monoradio102/stardust-lamp/research/2026-11-cosmic-rays/paper/stardust_en.pdf

## Measuring cosmic-ray muons with a desktop Geiger–M¨uller coincidence lamp

MONORADIO
https: // github. com/ monoradio102/ stardust-lamp (https://github.com/monoradio102/stardust-lamp)

(Dated: November 2026)

Hoshikuzu-to (“stardust lamp”) is a lamp that lights only when two stacked Geiger–M¨uller tubes fire together. We evaluate it as a counter of cosmic-ray muons. A 10-hour run on a desk indoors gave 1,162 coincidences, a rate of R = 1.94 ± 0.06 min⁻¹
. The counts per minute follow a Poisson distribution (χ

2
test, p = 0.1)
and the waiting times an exponential one (KS test, p = 0.4), as expected for independent arrivals. Chance coincidences agree with Racc = 2τRARB and make up 0.04% of the total. A Monte Carlo calculation of the geometric factor from the tube dimensions and the cos²
θ zenith-angle distribution gives a vertical intensity of I0 = 51.3–72.5 m⁻²
s

−1

sr⁻¹
, consistent with the accepted value of about 70. A separate 45.7-hour run with earlier firmware, corrected for double counting of single discharges, gives the same rate within the errors.
I. INTRODUCTION

Primary cosmic rays are mostly protons and nuclei accelerated in supernova remnants in our Galaxy. They collide with nuclei of the air some 15 km up, and the pions they make decay into muons. Most charged particles reaching the ground are these muons; about one crosses each square centimeter of a horizontal surface per minute.¹
The classic way to count them is the coincidence method: stack two or more detectors and keep only the events in which all of them fire. A single Geiger–M¨uller (GM) tube also responds to ambient gamma rays, but at ground level a particle that passes through two tubes at once is almost always a muon.
Hoshikuzu-to performs this coincidence with an analog circuit and shows the result as a soft glow of an LED (Fig. 1). Our aim is to show that the lamp also works as a quantitative instrument. We report (i) tests of the arrival statistics, (ii) a test of the chance-coincidence formula, (iii) a prediction of the rate from the tube geometry and an estimate of the vertical intensity, and (iv) a check of reproducibility with two runs.

II. APPARATUS AND METHOD

A. Detector

The detector is a pair of J321 GM tubes lying horizontally, one above the other (Table I, Fig. 2). A boost converter followed by a voltage doubler supplies the high voltage, which the microcontroller regulates at 360 V.

B. Coincidence and counting

The coincidence is made twice. For the light, charge flows through a two-stage PNP stack into a capacitor only while the pulses of both tubes overlap, so the window is set by the pulse overlap (about 0.1 ms). For the counts, a microcontroller (ATtiny1614) catches the


FIG. 1. Hoshikuzu-to: two stacked GM tubes (back) and the board that glows at the moment of a coincidence (front).

TABLE I. Detector and run conditions.

GM tubes | J321 × 2 (diameter 10 mm, glass 70 mm)
Layout | stacked, axes horizontal, ≈12 mm apart
High voltage | 360 V (run B: 359.2–360.1 V)
Window | τ = 100 µs
Dead time | τd = 200 µs per tube (firmware 1.5.0 on)
Site | indoors, on a desk

falling edge of each tube’s pulse in an interrupt and timestamps it to a microsecond; a pair with |∆t| ≤ τ is a coincidence. It also counts delayed coincidences D with the window shifted by 1 ms. A pulse that comes within τd = 200 µs of the last counted pulse of the same tube is taken as a repeat of the same discharge and ignored (dead time, firmware 1.5.0 on). Counts lost to a nonparalyzable dead time are corrected by n = m/(1−mτd), where n and m are the true and observed rates;⁴
for a
single tube at 20 min⁻¹

, mτd ≈ 7 × 10⁻⁵
, which is negligible. All numbers in this paper come from the digital counts.

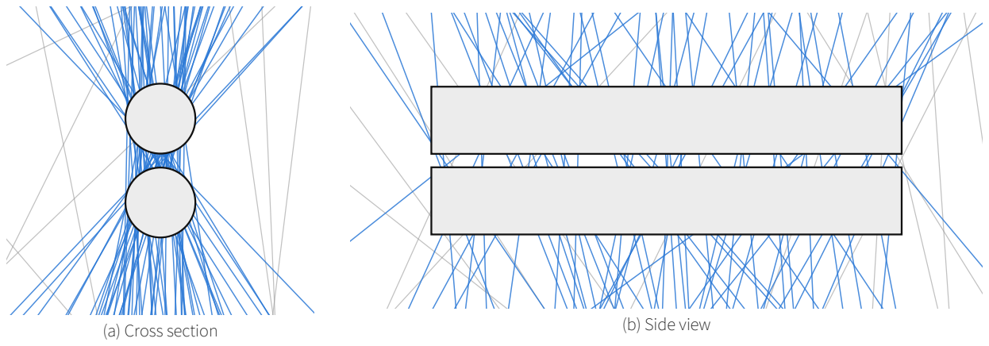
[picture p8: figure]
(a) Cross section; (b) Side view

FIG. 2. Detector geometry. Of the lines generated in the Monte Carlo, those through both tubes (blue, counted) and others (gray).

TABLE II. Runs.

| Firmware | Start (JST) | Length
Run A | 1.4.0 | 2026-11-07 11:01 | 45.7 h
Run B | 1.6.0 | 2026-11-09 09:30 | 10.0 h

TABLE III. Counts and rates (run B).

| Counts | Rate (min⁻¹
)
Coincidences C | 1,162 | 1.937 ± 0.057
Tube A | 10,302 | 17.17
Tube B | 8,130 | 13.55
Delayed D | 1 | —
C. Data taking

The board was connected over USB to a small PC, which recorded (1) 10-s summaries (high voltage, counts of tubes A and B, coincidences C, delayed coincidences D), (2) every hit with the PC’s time stamp (ms), and
(3) for pairs within 5 ms, ∆t = tB − tA measured on the board (µs). Table II lists the two runs. The main results come from run B; run A is used in Sec. III F to check reproducibility. Neither run has a gap longer than 25 s in its 10-s records.

III. RESULTS

A. Rates

Table III gives the counts of run B. The single-tube counts are mostly ambient gamma rays.

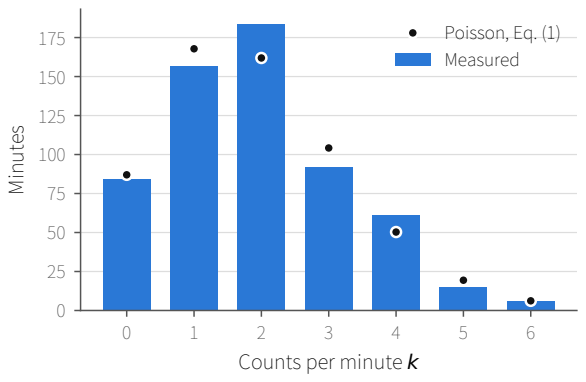
[picture p9: figure]
Counts per minute k; Minutes; Poisson, Eq. (1) Measured

FIG. 3. Coincidences per minute (599 minutes). Dots: Eq. (1) with λ = 1.93.

B. Arrival statistics

If arrivals are independent and the rate R is constant, the number k counted in a time ∆T follows the Poisson distribution and the waiting time ∆t the exponential one,

P(k) = λ

k
e

−λ
k!
, | λ = R ∆T, | (1)

p(∆t) = R e⁻R∆t

, | ∆t1/2 = ln 2 R
. | (2)

The counts per minute have mean 1.93 and variance 1.765, as σ

2 = λ requires (Fig. 3); a χ

2
test of the
whole distribution gives χ

2 = 9.2 for 5 degrees of freedom (p = 0.1). The median waiting time, 22.3 s, matches ∆t1/2 = 21.5 s from Eq. (2) (Fig. 4), and a KS test against the exponential gives p = 0.4. Neither test rejects independent arrivals.

0 | 50 | 100 | 150 | 200 | 250

### Waiting time Δt [s]

1

10

100

### Events / 10 s

Exponential, Eq. (2)
Measured

FIG. 4. Waiting times between coincidences (1,161 intervals). Line: Eq. (2).

0 | 1000 | 2000 | 3000 | 4000 | 5000
|Δt| [μs]

0.1

1

10

100

1,000

### Pairs / 100 μs

Eq. (3)
Coincidence window
Outside the window

FIG. 5. Distribution of |∆t| between the two tubes in 100-µs bins. Dashed line: chance level from Eq. (3).

C. Chance coincidences

Two unrelated hits fall in the window by chance at the rate

Racc = 2 τ RA RB. | (3)

For run B this predicts 0.47 chance events inside the window, 0.04% of the coincidences. Pairs outside the window (0.1 < |∆t| ≤ 5 ms) are all chance overlaps, so their distribution should be flat at the height set by Eq. (3) (Fig. 5). We find 17 such pairs against 22.8 expected, and a delayed-coincidence count of 1 against 0.94 expected.

D. Time differences

A muon crosses the two tubes, about 12 mm apart, in 0.04 ns. The measured time differences instead peak at a median of +16 µs, with 89% between +9 and +17 µs (Fig. 6). This offset comes not from the flight time but from the time the microcontroller takes to service the two

−100 −75 | −50 −25 | 0 | 25 | 50 | 75 | 100
Δt = tB − tA | [μs]

1

10

100

1,000

### Events / 2 μs

FIG. 6. Time differences ∆t | = tB − tA | inside the window.
interrupts in turn. | Both tubes share | one port interrupt,
and the handler services tube A first, so ∆t is shifted by
the run time of A’s | handler | (mean | +15.8 µs). When tube
B falls slightly earlier, the | order is | reversed, which gives
a small peak near −21.4 µs | (9.5% | of | all pairs).
E. Stability
The hourly coincidence | counts of | run B average 116.6
with χ
2 = 6.3 for | 8 degrees of | freedom (p = 0.62);
run A, after correction, gives χ

2 = 49.9 for 43 (p =
0.22). Neither shows changes beyond statistical fluctuation (Fig. 7).
F. | Comparison of the two | runs
Run A was taken | with earlier firmware (1.4.0), before
the dead time was | added. | Its event list contained, 6.8
times per hour, bursts of two to four | coincidences within
10 ms—a pattern that independent | arrivals would pro-
duce about twice in 45 hours. In | each burst one tube
fired again 20–96 µs after | its first | pulse, inside the win-
dow, so the same muon was counted again. Widening
the time differences | to 5 ms | showed | no excess of repeat
pulses beyond 100 µs.
Before correction | the rate | of run | A was 2.14 min⁻¹
,
and its hourly counts scattered more than a Poisson distribution allows (χ
2 = 62.5 | for 43 | degrees of freedom,
p = 0.027). | Treating hits | within | 10 ms on the PC
clock as one discharge brings the | scatter back to Pois-
son (χ
2 = 49.9, p = 0.22) | and gives | 1.98 ± 0.03 min⁻¹
,
which agrees with the 1.94 ± 0.06 min⁻¹
of run B within
0.7 σ (Table IV). In | run B | the burst | rate is 0.0 per hour,
and repeat hits of a tube within 10 ms occur 5.1 times per
hour against 4.8 expected | by chance. An error that the
mean alone would hide can | thus be | found and corrected
with the same statistical tests as in | Sec. III B, provided
every event is time-stamped.

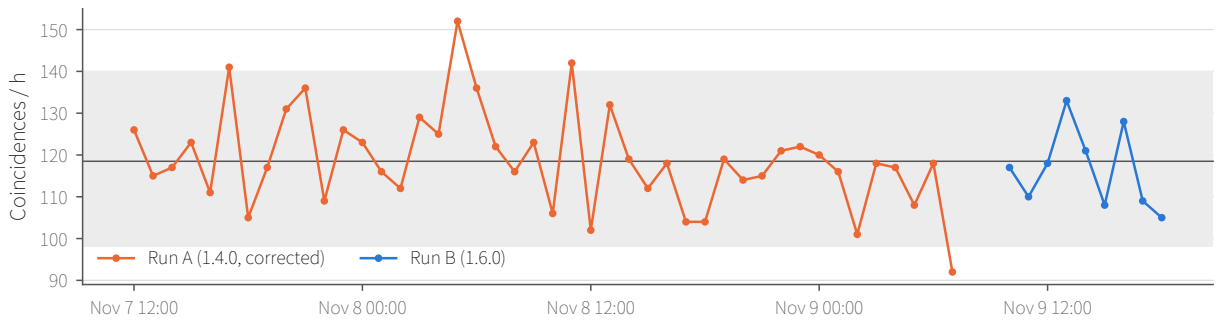
[picture p10: figure]
Nov 7 12:00; Nov 8 00:00; Nov 8 12:00; Nov 9 00:00; Nov 9 12:00; Coincidences / h; Run A (1.4.0, corrected); Run B (1.6.0)

FIG. 7. Hourly coincidences. The band holds 95% of a Poisson distribution with the mean shown by the line. Run A is corrected as described in Sec. III F.

TABLE IV. Comparison of the two runs. χ

2
is for the hourly
counts; a burst is coincidences following each other within 10 ms.
| | Run A | Run B
| raw | corrected
Rate (min⁻¹
) | 2.14 | 1.98 ± 0.03 | 1.94 ± 0.06
χ

2
/dof | 62.5/43 | 49.9/43 | 6.3/8
Its p value | 0.027 | 0.22 | 0.62
Bursts (h⁻¹
) | 6.8 | — | 0.0
IV. | GEOMETRIC ACCEPTANCE AND VERTICAL
INTENSITY

The intensity of muons at ground level depends on the zenith angle θ roughly as¹

I(θ) = I0 cos²
θ. | (4)

Let A⊥(θ, ϕ) be the area, projected on a plane perpendicular to the direction (θ, ϕ), of the bundle of lines that pass through both tubes. The rate is then

R = ε I0 G, G ≡

∫︂

Ω

cos²
θ A⊥(θ, ϕ) dΩ, (5)

where ε lumps together the detection efficiency and shielding. We computed the geometric factor G by a Monte Carlo that draws lines through a horizontal plane weighted by cos³
θ. Since the sensitive length of the tubes cannot be measured directly, we used both the glass length, 7 cm, and 5 cm, which leaves out the electrodes at the ends (Table V).
Solving Eq. (5) with ε = 1 gives I0 = R/G = 51.3– 72.5 m⁻²
s

−1

sr⁻¹
. The range includes the accepted value of about 70 m⁻²
s

−1

sr⁻¹

1 Shielding indoors and an efficiency below unity (ε < 1) make this consistent. The counted muons arrive at a median zenith angle of 27◦ (Fig. 8): the intensity peaks at the vertical, but the solid angle near the zenith is small, so the distribution peaks

TABLE V. Geometric factor and predicted rate (I0 = 70 m⁻²
s

−1

sr⁻¹
, ε = 1).
Length | G (cm²
sr) | Predicted | Measured | Ratio
5 cm | 4.45 | 1.87 | 1.94 | 1.04
7 cm | 6.29 | 2.64 | 1.94 | 0.73

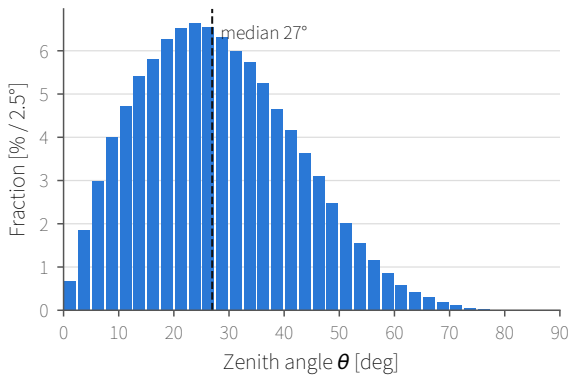
[picture p11: figure]
Zenith angle θ [deg]; Fraction [% / 2.5°]; median 27°

FIG. 8. Zenith angles of counted muons (Monte Carlo, 7-cm sensitive length).

at 20–30◦
. Systematic uncertainties in the predicted rate and in I0 come from the uncertain sensitive length (the spread in Table V), efficiency and shielding (ε), and the measured tube spacing (1 mm changes G by about 8%).
V. DISCUSSION: TIME DILATION

The muon lifetime is τµ = 2.197 µs,¹
so even at the
speed of light a muon would travel only cτµ ≈ 659 m. That muons made 15 km up are counted at the ground is due to the time dilation of special relativity,²,3

γ =

E
mµc

2

, L = γβcτµ,

N(h)
N0

= e

−h/L
. (6)

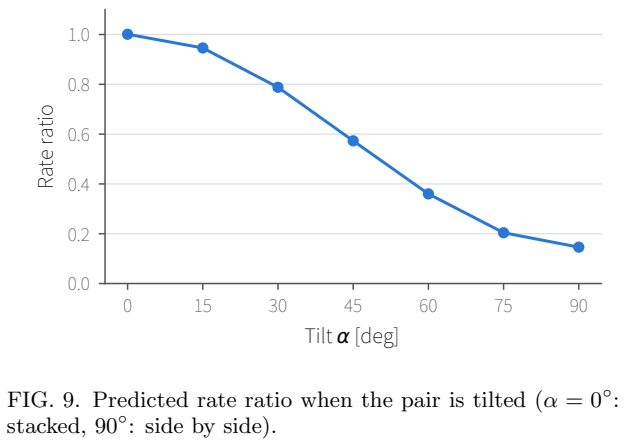
[picture p12: figure]
Tilt α [deg]; Rate ratio; stacked, 90◦; : side by side).

FIG. 9. Predicted rate ratio when the pair is tilted (α = 0◦

For a typical ground-level energy E ≈ 4 GeV, γ ≈ 38 and L ≈ 25 km, so a fraction 0.55 survives 15 km; without time dilation it would be 1.3×10⁻¹⁰ (energy loss in the air is ignored). The two coincidences a minute are a modest witness that time dilation is real.

VI. CONCLUSION

A lamp built as a decorative object works as a quantitative counter of cosmic-ray muons. The coincidence rate is 1.94 ± 0.06 min⁻¹
and the arrivals follow a Poisson process. Chance coincidences agree with Eq. (3) and make up 0.04% of the total. The prediction from the tube geometry and the cos²
θ distribution agrees with the measurement and gives I0 = 51.3–72.5 m⁻²
s

−1

sr⁻¹

Statistical tests on the event record found and corrected double counting in the counting chain, and after correction the two runs agree within the errors.

VII. FURTHER WORK

The relative statistical error is σR/R = 1/

√
N; one
lamp counts about 2,789 events a day, fixing the daily rate to ±1.9%. Tilting the pair by an angle α about the tube axis changes the accepted zenith angles; Fig. 9 shows the rate ratio predicted from Eq. (5), and a day at each angle would test Eq. (4). Other studies within reach are the barometric effect (∆R/R = β∆P with β ≈ −0.1 to −0.2%/hPa⁵
), Forbush decreases after solar eruptions,⁶
extensive air showers with two lamps, and the dependence on location.

DATA AND CODE

The analysis code, results, data, schematics and
firmware | are | available | at | https://github.com/
monoradio102/stardust-lamp. (https://github.com/monoradio102/stardust-lamp)

1S. Navas et al. (Particle Data Group), “Review of Particle Physics,” Phys. Rev. D 110, 030001 (2024).
2B. Rossi and D. B. Hall, “Variation of the rate of decay of mesotrons with momentum,” Phys. Rev. 59, 223 (1941).
3D. H. Frisch and J. H. Smith, “Measurement of the relativistic time dilation using µ-mesons,” Am. J. Phys. 31, 342 (1963). 4G. F. Knoll, Radiation Detection and Measurement, 4th ed. (Wiley, 2010).
5L. I. Dorman, Cosmic Rays in the Earth’s Atmosphere and Underground (Springer, 2004).
6S. E. Forbush, “On the effects in cosmic-ray intensity observed during the recent magnetic storm,” Phys. Rev. 51, 1108 (1937).
