monoradio102/stardust-lamp/research/2026-11-cosmic-rays/paper/stardust_ja.pdf

# 卓上ガイガー＝ミュラー管コインシデンス灯 「星屑灯」による宇宙線ミューオンの計測

## Measuring cosmic-ray muons with a desktop Geiger–Müller coincidence lamp MONORADIO

2026 年 11 月　 · https://github.com/monoradio102/stardust-lamp

要旨　上下に重ねた 2 本のガイガー＝ミュラー（GM）管が同時に反応したときだけ光るランプ「星屑灯」を，宇宙線ミューオンの計 数器として評価した．屋内の机上で 10.0 時間の連続観測を行い，1,162 事象の同時計数を得た．計数率は R = 1.94±0.06 min⁻¹ である．1 分ごとの計数はポアソン分布に（χ

2 検定 p = 0.1），到来間隔は指数分布に（KS 検定 p = 0.4）従い，到来が独立な 事象の列であることを確かめた．偶然同時計数は理論式 Racc = 2τRARB どおりで，全体の 0.04% にとどまる．管の寸法と天
頂角分布 I(θ) = I0 cos²

θ から幾何学的因子をモンテカルロ法で求め，鉛直強度 I0 = 51.3–72.5 m⁻²
s

−1

sr⁻¹ を得た．これは
文献値（約 70）と整合する．ファームウェアの異なる 45.7 時間の観測（同じ放電の二重計数を補正）とも，計数率は誤差の範 囲で一致した．
キーワード　宇宙線，ミューオン，GM 計数管，同時計数法，ポアソン過程，幾何学的因子

### 1 はじめに

一次宇宙線は，主に銀河内の超新星残骸で加速された
陽子や原子核である．これが上空 15 km 前後で大気の原 子核と衝突し，π 中間子を経てミューオンが生まれる．地 上に届く荷電粒子の大部分はこのミューオンであり，水
平な面 1 cm² あたり毎分およそ 1 個が通過する [1]． ミューオンを数える古典的な方法は，2 つ以上の検出器 を重ね，すべてが同時に反応した事象だけを選ぶ同時計
数法である．単独の GM 管は環境のガンマ線にも反応す るが，2 本を同時に貫く粒子は，地上ではほぼミューオン に限られる．
星屑灯は，この同時計数をアナログ回路で行い，その
結果を LED の光として見せる照明である（図 1）．本研 究の目的は，この装置が定量的な測定器として使えるこ
とを示すことにある．具体的には，(i) 到来の統計の検証， (ii) 偶然同時計数の理論式の検証，(iii) 管の幾何からの計 数率の予言と鉛直強度の推定，(iv) 2 回の観測による再現 性の確認，を報告する．

### 2 装置と方法

2.1 検出器
検出器は GM 管 J321 を 2 本，軸を水平にして上下に 重ねたものである（表 1，図 2）．高圧はブースト回路と倍 電圧回路で作り，マイコンが帰還をかけて 360 V に保つ． 2.2 同時計数と計数系
同時計数は 2 段で行う．光は，2 本の管のパルスが 重なっている間だけ，2 段の PNP トランジスタを通し てコンデンサに電荷が入ることで生じる．窓はパルスの
重なりで決まり，約 0.1 ms である．計数は，マイコン


図 1 星屑灯．上下に重ねた 2 本の GM 管（奥）と，同時計数 の瞬間に光る基板（手前）．

表 1 検出器と観測の条件
GM 管 | J321 × 2（外径 10 mm，ガラス長 70 mm）
配置 | 軸を水平に上下に重ねる．中心間隔 約 12 mm
印加電圧 360 V（観測 B の実測 359.2–360.1 V）
同時の窓 τ = 100 µs
不感時間 τd = 200 µs（管ごと，1.5.0 以降）
場所 屋内，机の上

（ATtiny1614）が各管のパルスの立ち下がりを割り込み で捉え，時刻を µs 単位で記録して行う．2 本の時間差が |∆t| ≤ τ のとき同時計数とする．あわせて，窓を 1 ms ず らした遅延同時計数 D を数える．同じ管のパルスが，直 前に数えたパルスから τd = 200 µs 以内に来た場合は，同 じ放電の再パルスとみなして数えない（不感時間，ファー ムウェア 1.5.0 以降）．非まひ型の不感時間による数え落 としは，真の計数率を n，観測した計数率を m として n = m/(1−mτd) で補正できる [4]．単独の管で 20 min⁻¹ でも mτd ≈ 7 × 10⁻⁵ であり，補正は無視できる．本論

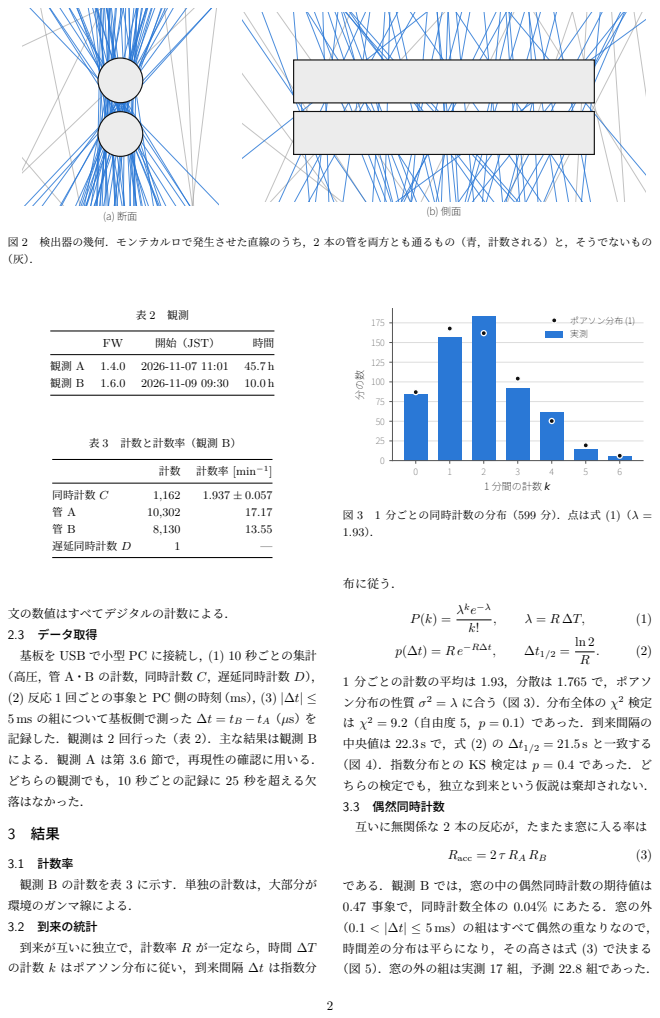
[picture p21: page 2]
開始（JST）; 表 3 計数と計数率（観測 B）; 同時計数 C; 遅延同時計数 D; 1 分間の計数 k; 分の数; ポアソン分布 (1) 実測; 図 3 1 分ごとの同時計数の分布（599 分）．点は式 (1)（λ =; 布に従う．; 2 = λ に合う（図 3）．分布全体の χ; Racc = 2 τ RA RB

図 2 検出器の幾何．モンテカルロで発生させた直線のうち，2 本の管を両方とも通るもの（青，計数される）と，そうでないもの

計数 計数率 [min⁻¹

文の数値はすべてデジタルの計数による．
2.3 データ取得
基板を USB で小型 PC に接続し，(1) 10 秒ごとの集計
（高圧，管 A・B の計数，同時計数 C，遅延同時計数 D），
(2) 反応 1 回ごとの事象と PC 側の時刻（ms），(3) |∆t| ≤
5 ms の組について基板側で測った ∆t = tB − tA（µs）を
記録した．観測は 2 回行った（表 2）．主な結果は観測 B
による．観測 A は第 3.6 節で，再現性の確認に用いる．
どちらの観測でも，10 秒ごとの記録に 25 秒を超える欠
落はなかった．
3.1 計数率
観測 B の計数を表 3 に示す．単独の計数は，大部分が
環境のガンマ線による．
3.2 到来の統計
到来が互いに独立で，計数率 R が一定なら，時間 ∆T
の計数 k はポアソン分布に従い，到来間隔 ∆t は指数分

1 分ごとの計数の平均は 1.93，分散は 1.765 で，ポアソ
ン分布の性質 σ
2 = 9.2（自由度 5，p = 0.1）であった．到来間隔の
中央値は 22.3 s で，式 (2) の ∆t1/2 = 21.5 s と一致する
（図 4）．指数分布との KS 検定は p = 0.4 であった．ど
ちらの検定でも，独立な到来という仮説は棄却されない．
3.3 偶然同時計数
互いに無関係な 2 本の反応が，たまたま窓に入る率は

である．観測 B では，窓の中の偶然同時計数の期待値は
0.47 事象で，同時計数全体の 0.04% にあたる．窓の外
（0.1 < |∆t| ≤ 5 ms）の組はすべて偶然の重なりなので，
時間差の分布は平らになり，その高さは式 (3) で決まる
（図 5）．窓の外の組は実測 17 組，予測 22.8 組であった．

0 | 50 | 100 | 150 | 200 | 250
到来間隔 Δt [s]

1

10

100
事象数 / 10 s

指数分布 (2)
実測

図 4 同時計数の到来間隔の分布（1,161 個）．線は式 (2)．

0 | 1000 | 2000 | 3000 | 4000 | 5000
|Δt| [μs]

0.1

1

10

100

1,000

組

の

数 / 100 μs

式 (3) の予測
同時の窓
窓の外

図 5 2 本の管の時間差 |∆t| の分布（100 µs ごと）．破線は 式 (3) から求めた偶然同時計数の高さ．

遅延同時計数 D も，予測 0.94 事象に対して実測 1 事象 であった．
3.4 時間差分布
ミューオンは約 12 mm 離れた 2 本の管を 0.04 ns で通 り抜ける．一方，測った時間差の中央値は +16 µs で，同 時計数の 89% が +9–+17 µs に集まる（図 6）．この差は 粒子の飛行時間ではなく，マイコンが 2 本の割り込みを 順に処理する時間による．2 本の管の信号は同じポート の割り込みで受け，マイコンは管 A から順に処理する． そのため ∆t は管 A の処理時間だけ正にずれる（平均 +15.8 µs）．管 B がわずかに早く立ち下がると処理の順 が入れ替わり，−21.4 µs 付近に小さな山（全体の 9.5%） ができる．
3.5 時間的な安定性
観測 B の 1 時間ごとの計数は平均 116.6 で，ばらつ きの χ

2 は 6.3（自由度 8，p = 0.62）であった．観測 A （補正後）も χ

2 = 49.9（自由度 43，p = 0.22）で，統計
的な揺れを超える変化は見られない（図 7）．
3.6 2 回の観測の比較
観測 A は，不感時間を入れる前のファームウェア
（1.4.0）で行った．その事象列には，10 ms 以内に同時
−100 −75 | −50 −25 | 0 | 25 | 50 | 75 | 100
Δt = tB − tA | [μs]

1

10

100

1,000

事

象

数 / 2 μs

図 6 窓の中の時間差 ∆t = tB − tA の分布．

表 4 2 回の観測の比較．χ

2 は 1 時間ごとの計数のばらつき，
塊は 10 ms 以内に続く同時計数．
観測 A | 観測 B
| 補正前 | 補正後
計数率 [min⁻¹
] | 2.14 | 1.98 ± 0.03 1.94 ± 0.06

χ

2

/自由度 | 62.5/43 | 49.9/43 | 6.3/8
その p 値 | 0.027 | 0.22 | 0.62
塊 [h⁻¹
] | 6.8 | — | 0.0

計数が 2–4 回続く塊が 1 時間あたり 6.8 回あった．到来 が独立なら，45 時間でおよそ 2 回しか起きない並びであ る．塊の中では，片方の管が最初のパルスから 20–96 µs 遅れて再びパルスを出し，それが窓に入って同じミュー
オンを重ねて数えていた．時間差を 5 ms まで広げても， 100 µs より外に再パルスの過剰はなかった．
補正前の計数率は 2.14 min⁻¹ で，1 時間ごとのばらつ きもポアソン分布より大きかった（χ
| | | 2 = 62.5，自由度
43，p = 0.027）．PC 側の時刻で 10 ms 以内に続いた反 応を 1 回の放電にまとめると，χ
2 | = | 49.9（p = 0.22）で
ポアソンの揺れに収まり，計数率は 1.98 ± 0.03 min⁻¹ と なった．不感時間を入れた観測 B の 1.94 ± 0.06 min⁻¹ とは，差が 0.7 σ で一致する（表 4）．観測 B では塊は 1 時間あたり 0.0 回，同じ管の 10 ms 以内の再反応は 5.1 回で，偶然に重なる期待値 4.8 回と変わらない．平均値だ けでは気づきにくい誤りも，事象ごとの時刻を残してお
けば，第 3.2 節と同じ統計の検定で見つけて補正できる．

### 4 幾何学的受け入れと鉛直強度

地上のミューオンの強度は，天頂角 θ に対して近似的に

I(θ) = | I0 cos²
θ | (4)
と表される [1]．方向 (θ, ϕ) | について，2 本の管を両方と
も通る直線の束をその方向に垂直な面へ射影した面積を

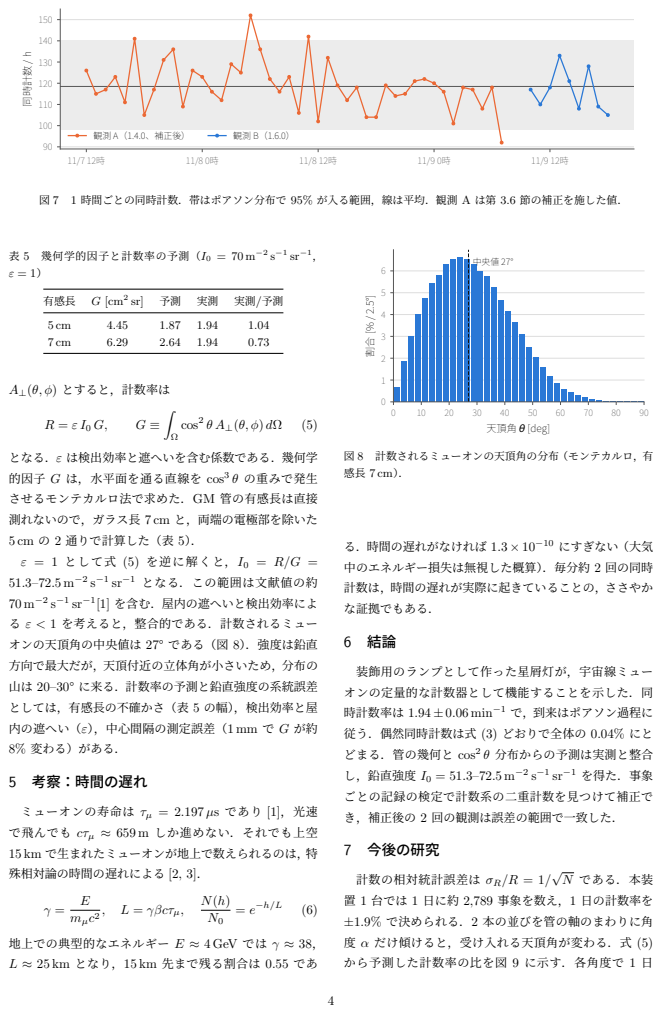
[picture p22: page 4]
同時計数 / h; 観測 A（1.4.0、補正後）; 表 5 幾何学的因子と計数率の予測（I0 = 70 m⁻²; 有感長 G [cm²; A⊥(θ, ϕ) とすると，計数率は; cos²; θ の重みで発生; mµc; L = γβcτµ,; 天頂角 θ [deg]; 中央値 27°; 図 8 計数されるミューオンの天頂角の分布（モンテカルロ，有 感長 7 cm）．; θ 分布からの予測は実測と整合; sr⁻¹ を得た．事象; √ N である．本装

図 7 1 時間ごとの同時計数．帯はポアソン分布で 95% が入る範囲，線は平均．観測 A は第 3.6 節の補正を施した値．

となる．ε は検出効率と遮へいを含む係数である．幾何学
的因子 G は，水平面を通る直線を cos³
させるモンテカルロ法で求めた．GM 管の有感長は直接
測れないので，ガラス長 7 cm と，両端の電極部を除いた
5 cm の 2 通りで計算した（表 5）．
ε = 1 として式 (5) を逆に解くと，I0 = R/G =

る．時間の遅れがなければ 1.3 × 10⁻¹⁰ にすぎない（大気
中のエネルギー損失は無視した概算）．毎分約 2 回の同時
計数は，時間の遅れが実際に起きていることの，ささやか
な証拠でもある．

sr⁻¹ となる．この範囲は文献値の約
[1] を含む．屋内の遮へいと検出効率によ
る ε < 1 を考えると，整合的である．計数されるミュー
オンの天頂角の中央値は 27° である（図 8）．強度は鉛直
方向で最大だが，天頂付近の立体角が小さいため，分布の
山は 20–30° に来る．計数率の予測と鉛直強度の系統誤差
としては，有感長の不確かさ（表 5 の幅），検出効率と屋
内の遮へい（ε），中心間隔の測定誤差（1 mm で G が約
8% 変わる）がある．
5 考察：時間の遅れ

装飾用のランプとして作った星屑灯が，宇宙線ミュー
オンの定量的な計数器として機能することを示した．同
時計数率は 1.94 ± 0.06 min⁻¹ で，到来はポアソン過程に
従う．偶然同時計数は式 (3) どおりで全体の 0.04% にと
どまる．管の幾何と cos²
し，鉛直強度 I0 = 51.3–72.5 m⁻²
ごとの記録の検定で計数系の二重計数を見つけて補正で
き，補正後の 2 回の観測は誤差の範囲で一致した．
7 今後の研究

ミューオンの寿命は τµ = 2.197 µs であり [1]，光速
で飛んでも cτµ ≈ 659 m しか進めない．それでも上空
15 km で生まれたミューオンが地上で数えられるのは，特
殊相対論の時間の遅れによる [2, 3]．

計数の相対統計誤差は σR/R = 1/
置 1 台では 1 日に約 2,789 事象を数え，1 日の計数率を
±1.9% で決められる．2 本の並びを管の軸のまわりに角
度 α だけ傾けると，受け入れる天頂角が変わる．式 (5)
から予測した計数率の比を図 9 に示す．各角度で 1 日

地上での典型的なエネルギー E ≈ 4 GeV では γ ≈ 38，
L ≈ 25 km となり，15 km 先まで残る割合は 0.55 であ

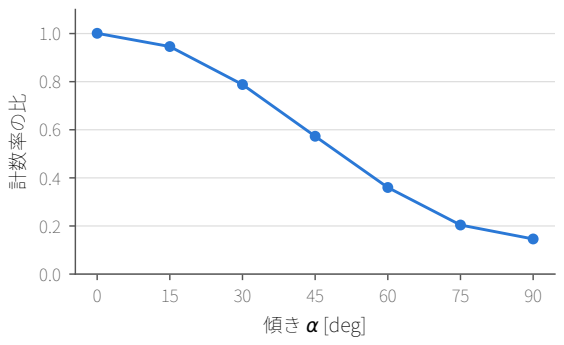
[picture p23: figure]
傾き α [deg]; 計数率の比

図 9 2 本の並びを傾けたときの計数率の比の予測（α = 0 が 上下，90° が横並び）．

ずつ測れば式 (4) を検証できる．このほか，気圧効果

（∆R/R = β∆P，β ≈ −0.1 から −0.2 %/hPa[5]），太陽
活動による減少（フォーブッシュ減少 [6]），2 台による空 気シャワーの検出，場所による違いの測定が可能である．

### データとコード

解 析 コ ー ド， 結 果 の 数 値， デ ー タ， 回 路 図， フ ァームウェアは https://github.com/monoradio102/stardust-lamp (https://github.com/monoradio102/stardust-lamp) で公開している．

### 参考文献

[1] S. Navas et al. (Particle Data Group), Phys. Rev. D 110, 030001 (2024).
[2] B. Rossi and D. B. Hall, Phys. Rev. 59, 223 (1941).
[3] D. H. Frisch and J. H. Smith, Am. J. Phys. 31, 342 (1963).
[4] G. F. Knoll, Radiation Detection and Measurement, 4th ed. (Wiley, 2010).
[5] L. I. Dorman, Cosmic Rays in the Earth’s Atmosphere and Underground (Springer, 2004).
[6] S. E. Forbush, Phys. Rev. 51, 1108 (1937).
