monoradio102/stardust-lamp/research/2026-11-cosmic-rays/paper/figures/en/coincidence.pdf

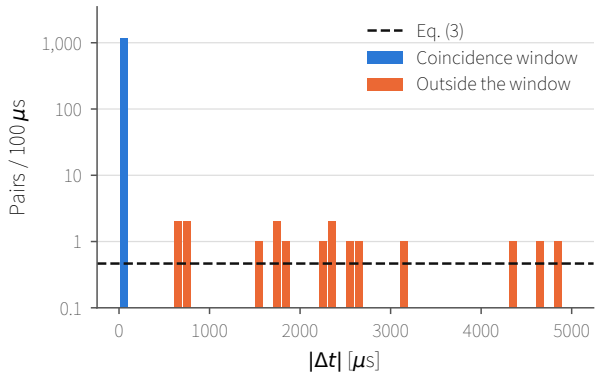
[picture p24: figure]
Pairs / 100 μs; Eq. (3) Coincidence window Outside the window
