monoradio102/stardust-lamp/research/2026-11-cosmic-rays/paper/figures/en/zenith.pdf

0 | 10 | 20 | 30 | 40 | 50 | 60 | 70 | 80 | 90 Zenith angle θ [deg]

0123456
Fraction [% / 2.5°]

median 27°
