monoradio102/stardust-lamp/research/2026-11-cosmic-rays/paper/figures/ja/coincidence.pdf

0 | 1000 | 2000 | 3000 | 4000 | 5000 |Δt| [μs]

0.11

10

100

1,000

組の数 / 100 μs

式 (3) の予測
同時の窓
窓の外
