monoradio102/stardust-lamp/brand/hoshikuzu_horizontal_ink.png

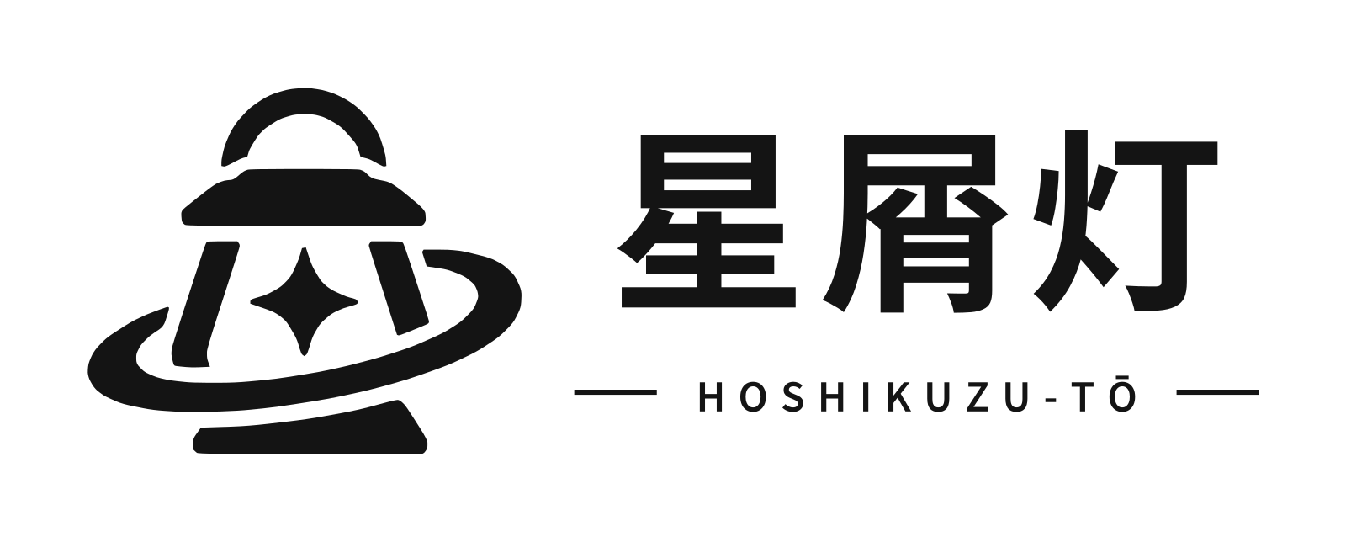
brand/hoshikuzu_horizontal_ink.png
