monoradio102/stardust-lamp/brand/hoshikuzu_stacked_ink.png

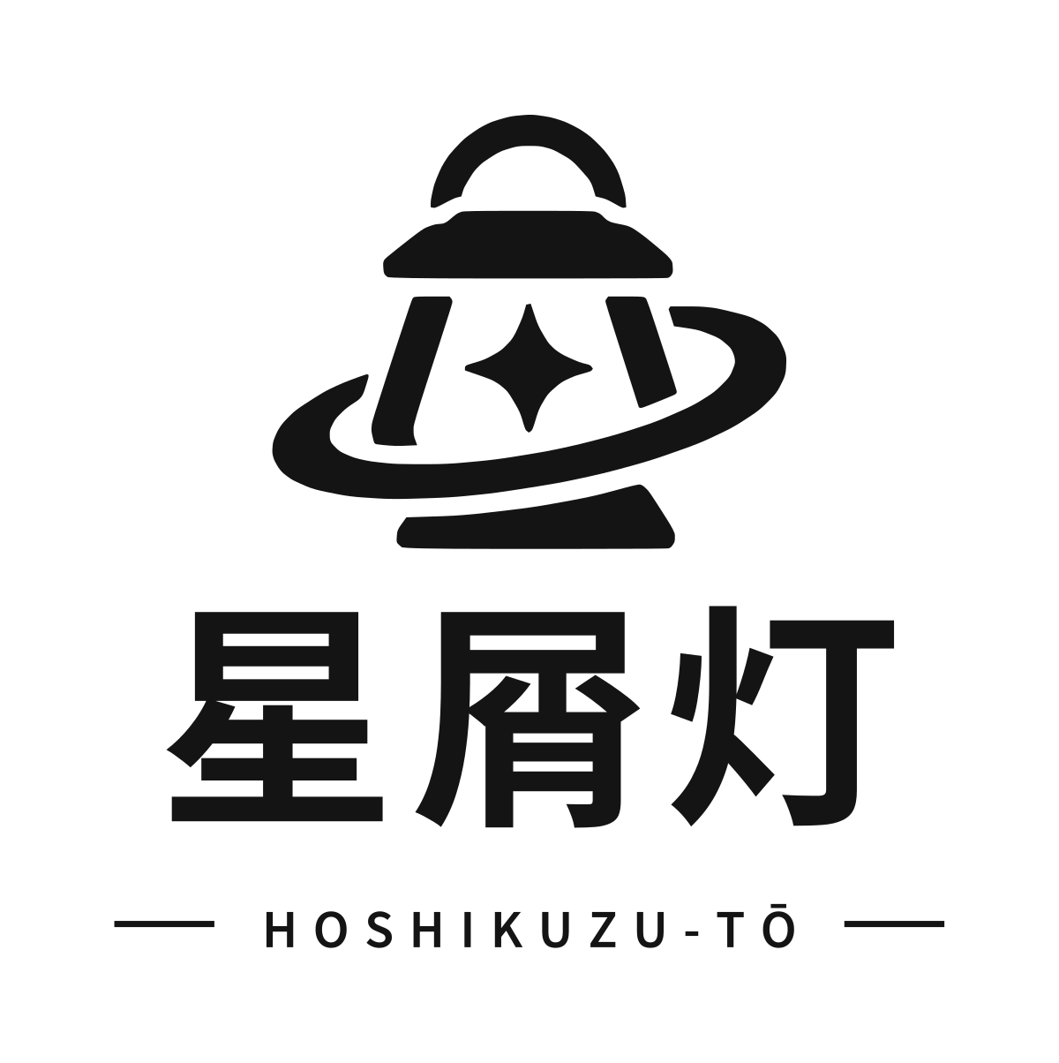
brand/hoshikuzu_stacked_ink.png
