monoradio102/stardust-lamp/hardware/images/schematic_1.png

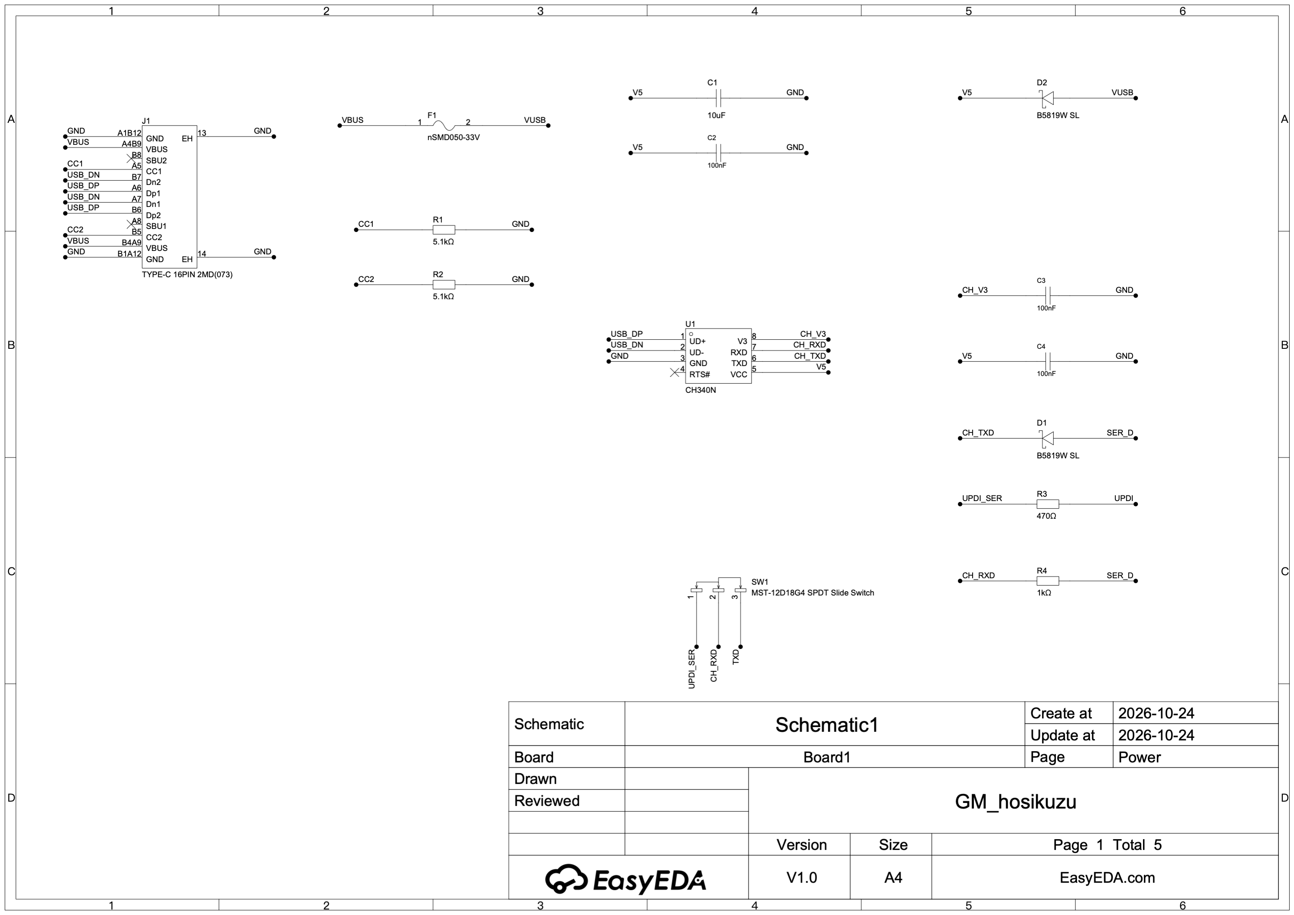
hardware/images/schematic_1.png
