monoradio102/stardust-lamp/hardware/images/schematic_2.png

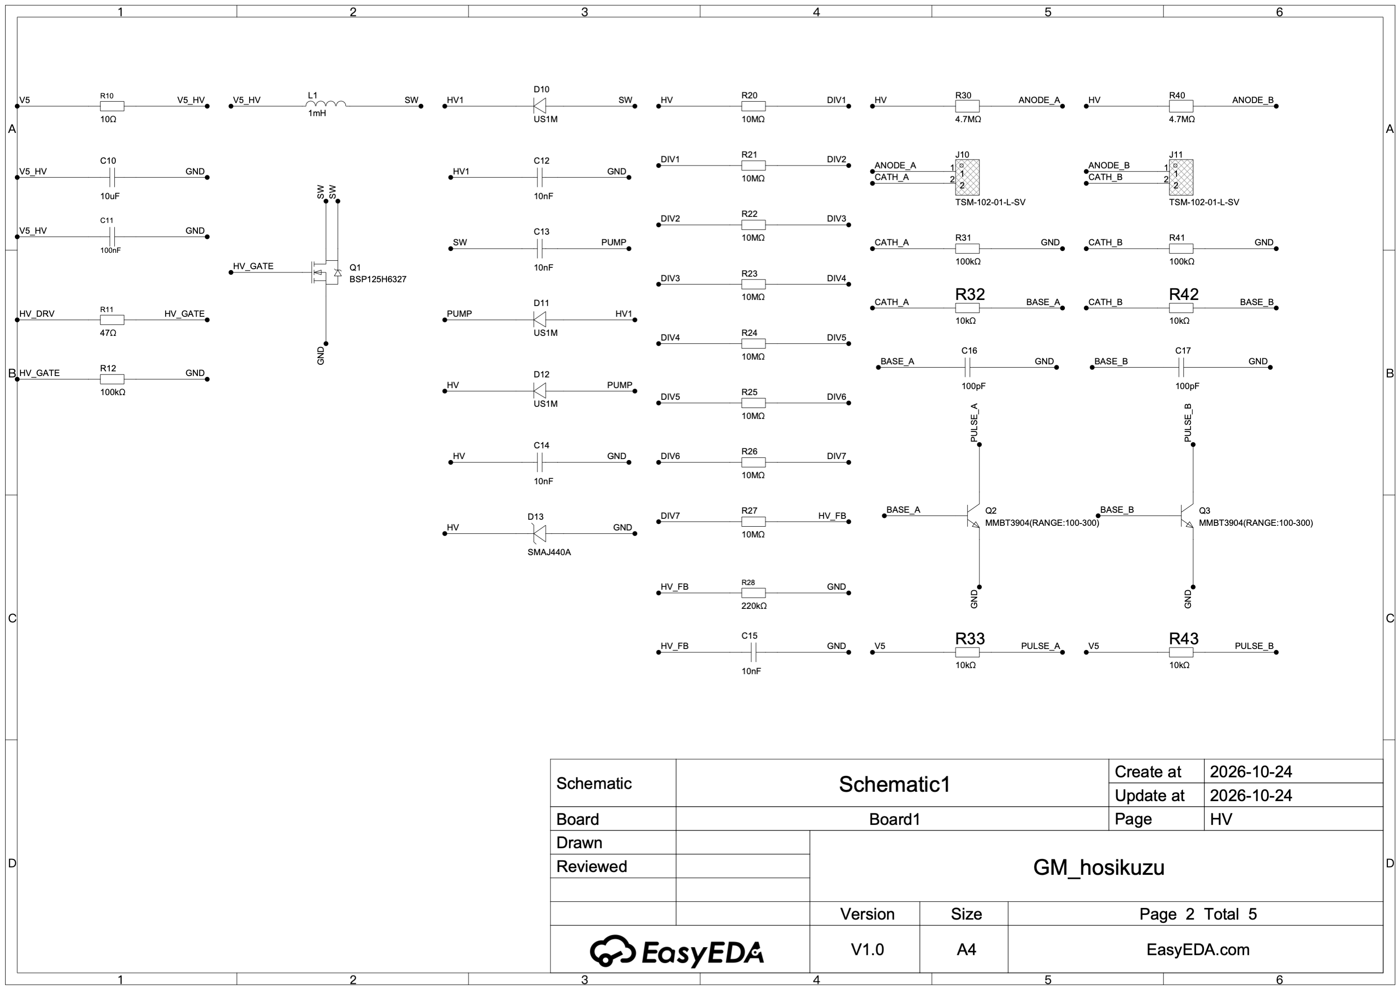
hardware/images/schematic_2.png
