monoradio102/stardust-lamp/hardware/images/schematic_3.png

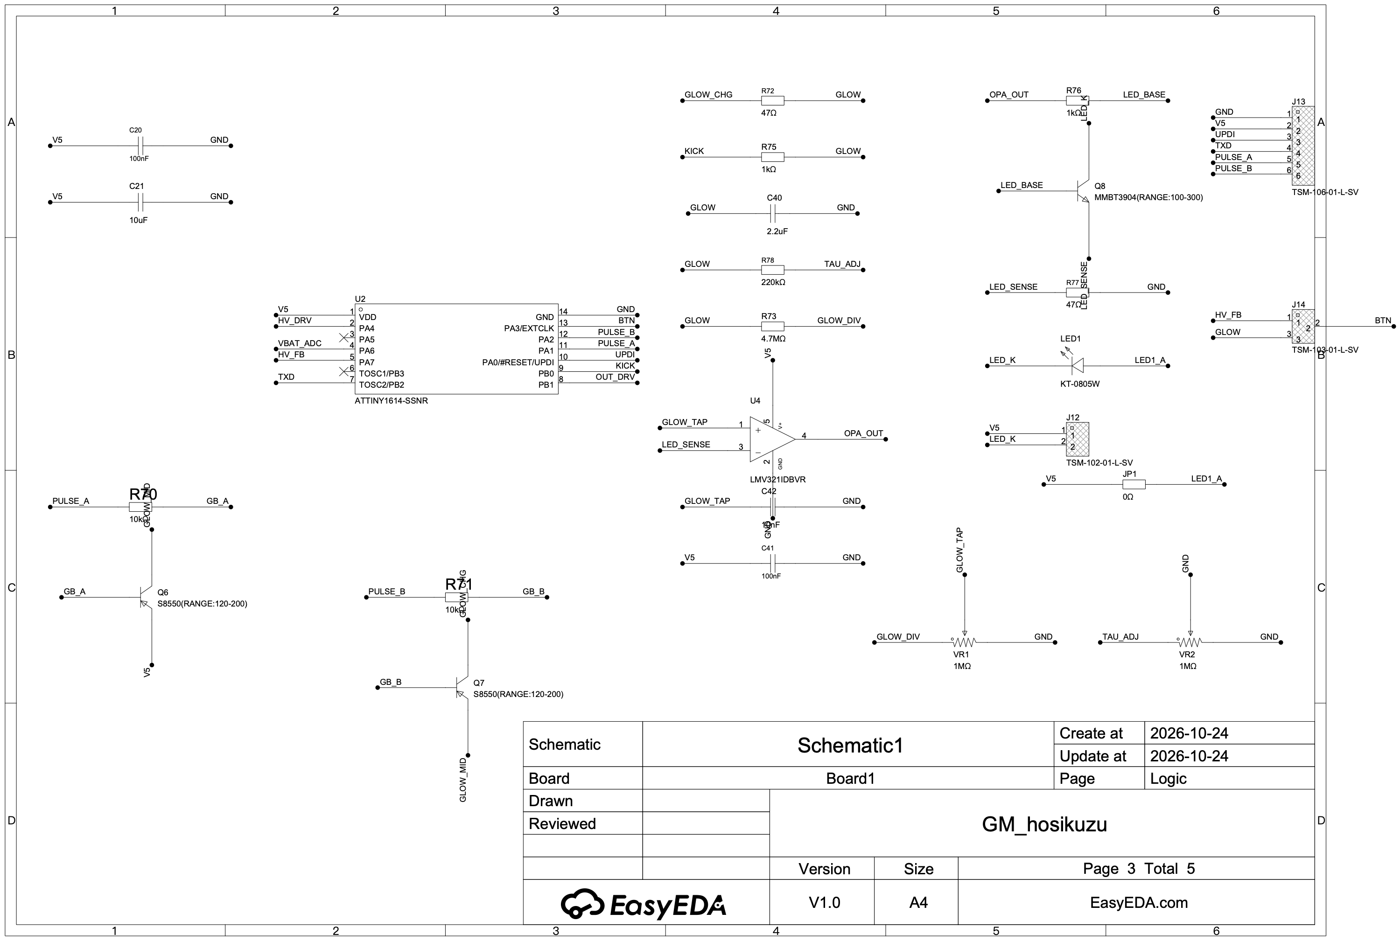
hardware/images/schematic_3.png
