monoradio102/stardust-lamp/hardware/images/schematic_4.png

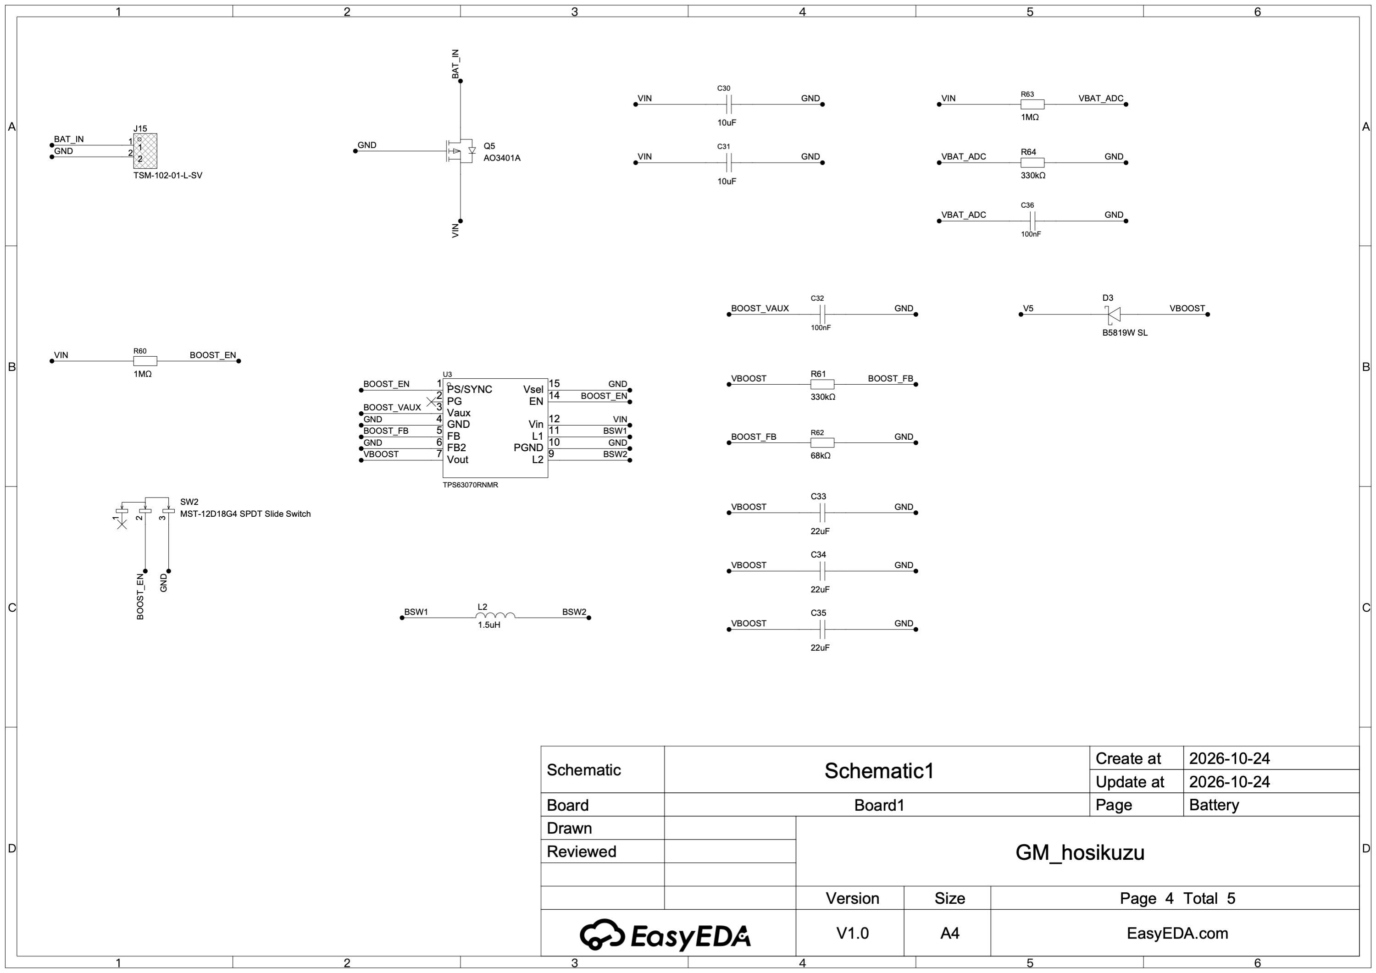
hardware/images/schematic_4.png
