monoradio102/stardust-lamp/hardware/images/schematic_5.png

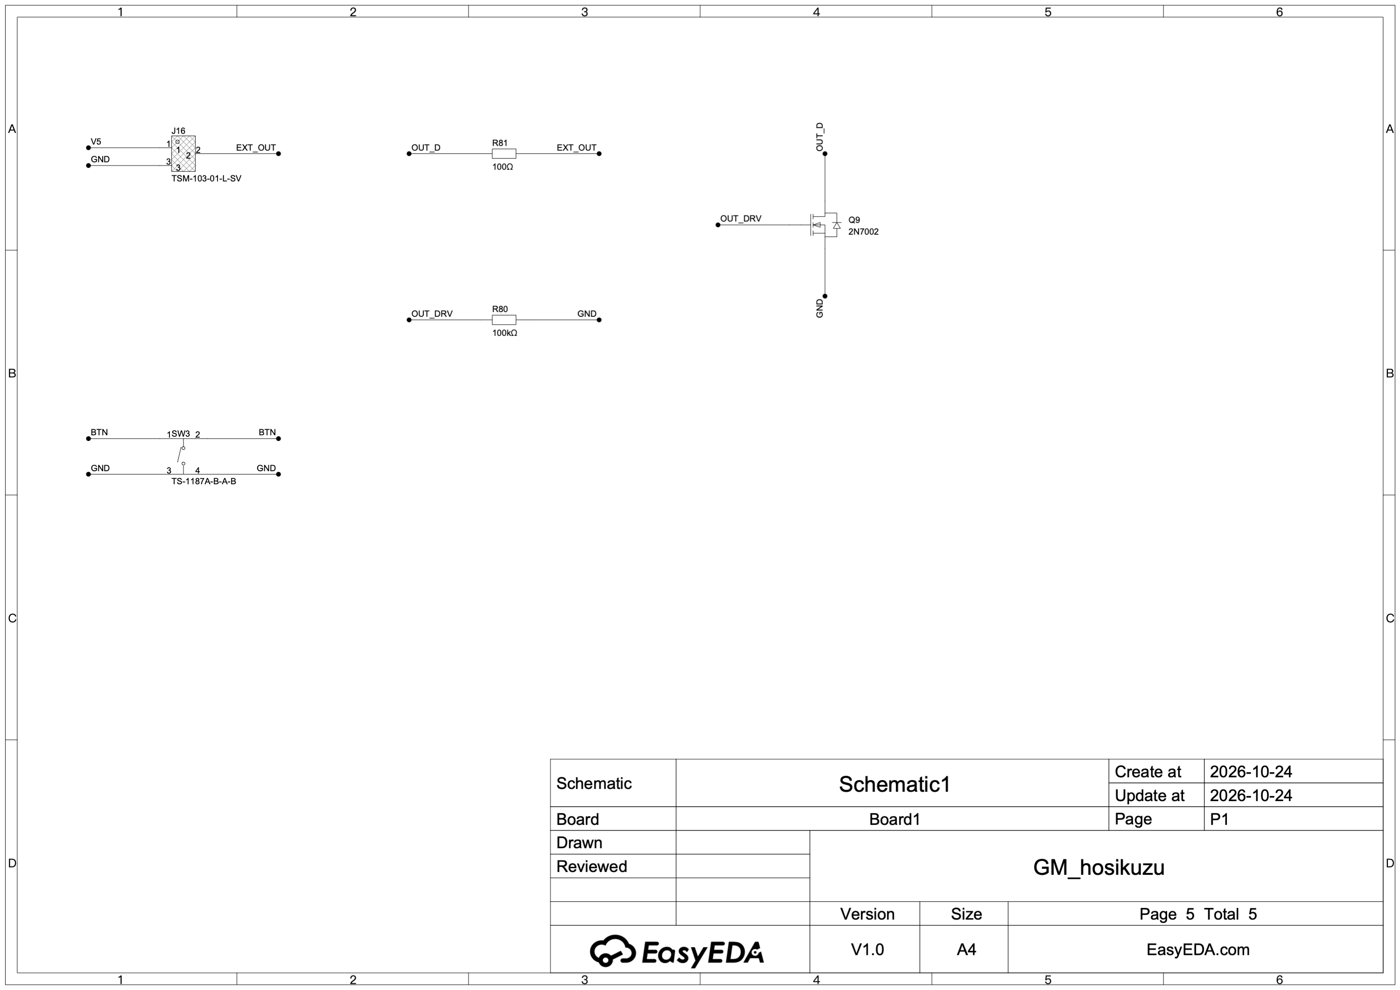
hardware/images/schematic_5.png
