monoradio102/stardust-lamp/research/2026-11-cosmic-rays/figures/coincidence_dark.png

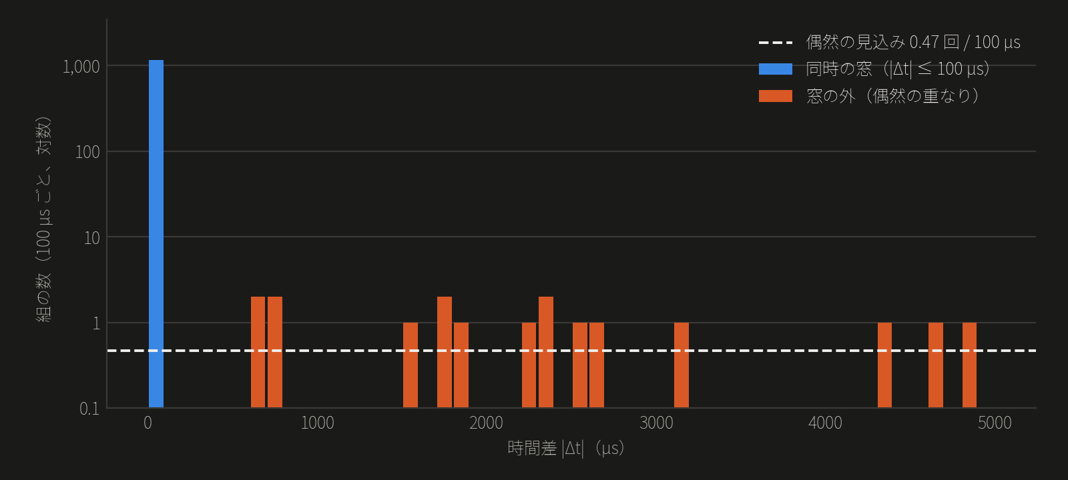
research/2026-11-cosmic-rays/figures/coincidence_dark.png
