monoradio102/stardust-lamp/research/2026-11-cosmic-rays/figures/detector_dark.png

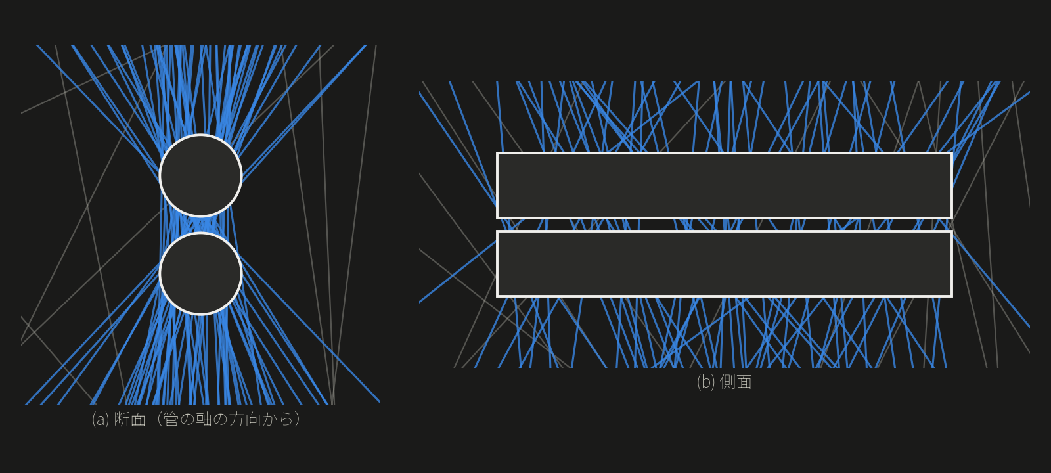
research/2026-11-cosmic-rays/figures/detector_dark.png
