monoradio102/stardust-lamp/research/2026-11-cosmic-rays/figures/tilt_dark.png

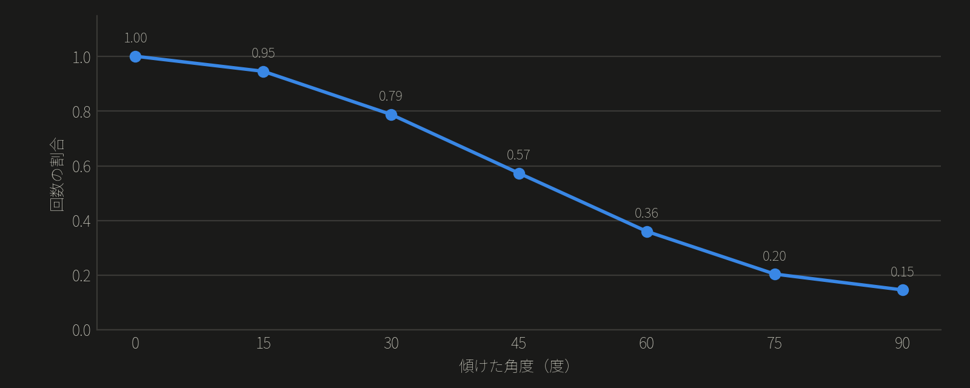
research/2026-11-cosmic-rays/figures/tilt_dark.png
