monoradio102/stardust-lamp/firmware/stardust/CHANGELOG.md

# 星屑灯 v1 ファームの変更履歴

バージョンは `stardust.ino` の `FW_VERSION`。書き込むたびに上げる。

- MAJOR: ログやコマンドの形が変わり、古いモニターやスクリプトが読めなくなるとき
- MINOR: コマンドや動きを足したとき
- PATCH: 直しだけのとき

基板では、起動時の 1 行目、`status` の末尾（`fw x.y.z`）、`version`（ビルド日時つき）で分かる。

設定の EEPROM の形（MAGIC）を変えたときは、そのことも書く。

## 1.6.0 — 2026-11-09

- 高圧のパルス駆動（`hvon` が 0 以外）で、パルスを均等な間隔で打つようにした
  - 1.3.0〜1.5.0 は、高圧が足りないと 1 ms まるごと 31 kHz で回していた。必要なのは時間の約 7% なので、14 ms に 1 回ほど不規則に 1 ms の束が出る形になり、そのたびに高圧が跳ねて、何もないときも LED がチラついていた（高圧を止めると消え、管が反応しない 250 V でも残り、連続駆動では消えた）
  - オンとオフの判断は今までどおり 1 ms ごと。オンのときのパルスの間隔を、オンの割合が約 70% になるようにゆっくり合わせる（TCD0 を 5 MHz で数え、32〜819 µs）。1 回のパルスの長さ（`hvon 300` = 15 µs）は同じ
  - 高圧の揺れ: 363〜372V → 359.5〜360.0V（1 秒ごとのログ）。パルスの数（ログの on 列）は 70 前後 → 66 前後で、電力はほぼ同じ見込み
  - チラつきは消え、耳を近づけても音は聞こえない
- ログの on 列（パルス駆動のとき）は、送ったパルスの数を 31 kHz 連続の何割かで表す（0.1% 単位）。前の「駆動していた時間の割合」と同じ目盛り

## 1.5.0 — 2026-11-09

- 管ごとの不感時間（`dead <us>`、既定 200 µs）。同じ管のパルスが、前に数えたパルスから 200 µs 以内なら数えない（0 で前と同じく全部数える）
  - 11-07〜09 の 45.7 時間の記録で、1 個のミューオンを 2〜4 回数えている場面が 2 本同時の約 7.6% あった。片方の管が 20〜90 µs 遅れてもう一度パルスを出し、それが同時の幅（100 µs）の内側に入っていた。1 本ずつの数も A が 7.5%、B が 3.2% 多かった
  - 余分なパルスは 100 µs 以内にしかなかった（100 µs〜5 ms は偶然の重なりと同じ平らな分布）ので、その 2 倍にした。毎分 20 回ほどの管なら、本物の数え落としは 1 万回に 1 回以下
  - 光り方（アナログの同時回路）は変わらない。変わるのはマイコンの数（ログの A・B・C、`ev`、`dt`）だけ
- `status` に `dead <us>` を足した（`win` の次）
- 設定に `deadUs` を足した（MAGIC 0x5D04。0x5D03・0x5D02 の設定はそのまま引き継ぎ、`dead` だけ既定値になる）

## 1.4.0 — 2026-11-07

- `ev on|off`: 管の反応を 1 回ずつ `e,A` / `e,B`、2 本同時を `e,C` で知らせる（Web モニターの表示用。保存しない）
- `version` コマンド。`status` の末尾と起動時の 1 行目にバージョンを出す
- モードの点滅中も高圧の制御を回す（`waitMs()`）。1.3.0 では digital に切り替えたとき、点滅の間に高圧が上がりすぎて過電圧で止まった
- 過電圧の知らせは 1 回だけ出す

## 1.3.0 — 2026-11-07

- 高圧をバースト駆動に（`hvon <counts>`、既定 300 = 15 µs。0 で従来の連続駆動）。1 ms ごとに目標より低いときだけ回す。電池 2 本で 25 mA → 13.8 mA
- 待ち時間にマイコンを idle で休ませる（KICK・OUT のパルス中は休まない）
- 設定に `burstOn` を足した（MAGIC 0x5D03。0x5D02 の設定はそのまま引き継ぐ）

## 1.2.0 — 2026-11-07

- `dt on|off`: 2 本の反応の時間差（5 ms 以内）を `dt,<µs>` で出す

## 1.1.0 — 2026-11-06

- rad モードの光り方: 1 回ごとに `flash <ms>` だけ光らせ、すぐ消す（KICK を LOW にして残光を抜く）
- ログの間隔を短くしたとき、追いつき分をまとめて出さない
- 設定に `flashMs` を足した（MAGIC 0x5D02）

## 1.0.0 — 2026-11-06

- 立ち上げ時のファーム: 高圧の PI 制御と過電圧停止、管ごとのカウントと同時計数、シリアルのログとコマンド、プラトー測定（`sweep`）、3 つのモード、EEPROM の設定
