monoradio102/stardust-lamp/hardware/schematic.pdf

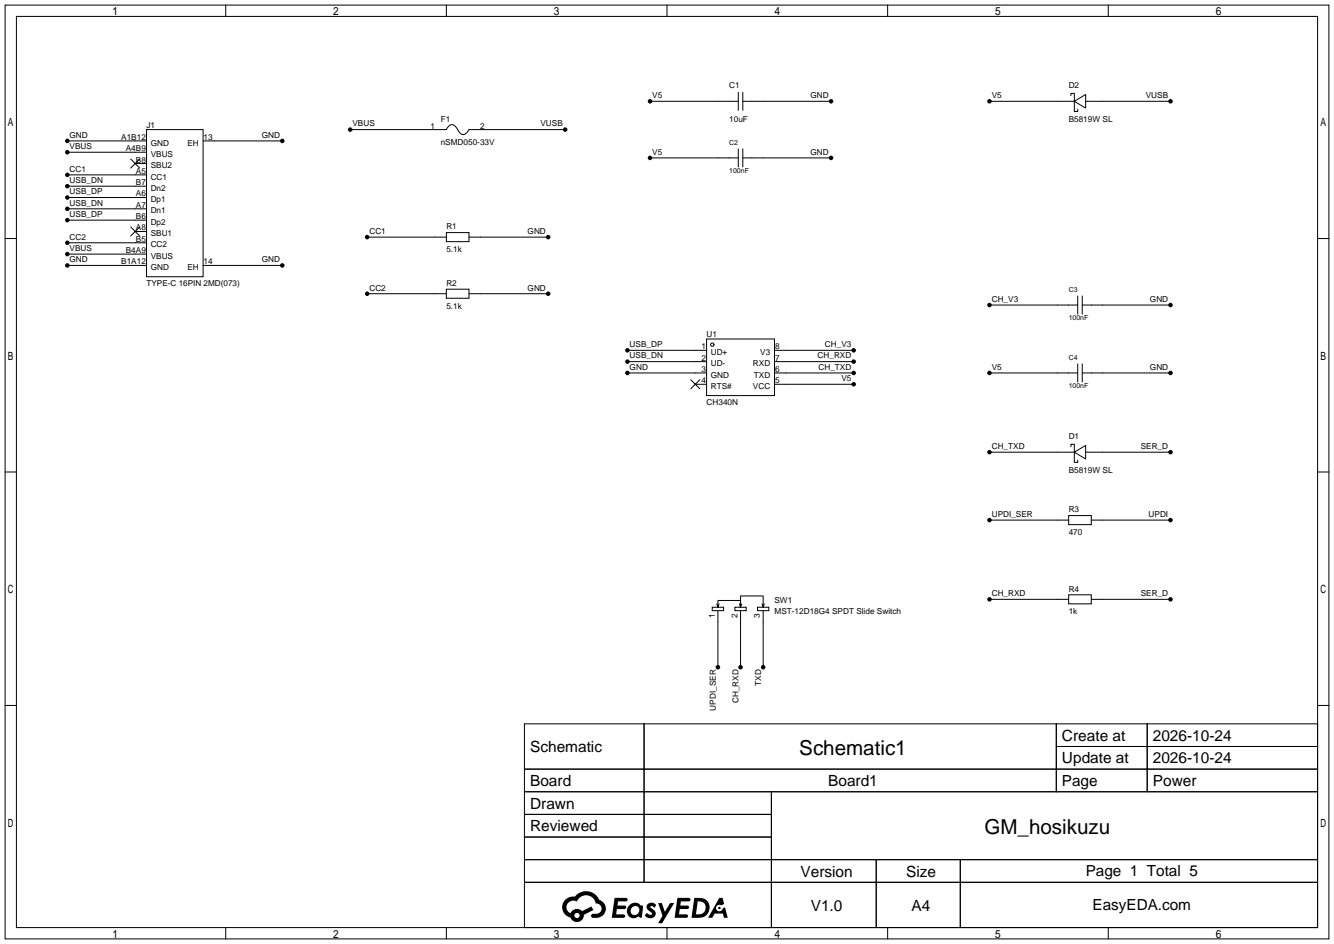
[picture p40: page 1]

MST-12D18G4 SPDT Slide Switch

Schematic | Schematic1 | Create at | 2026-10-24

Update at | 2026-10-24

Board | Board1 | Page | Power
Drawn | | GM_hosikuzu
Reviewed

Version | Size | Page 1 Total 5
V1.0 | A4 | EasyEDA.com

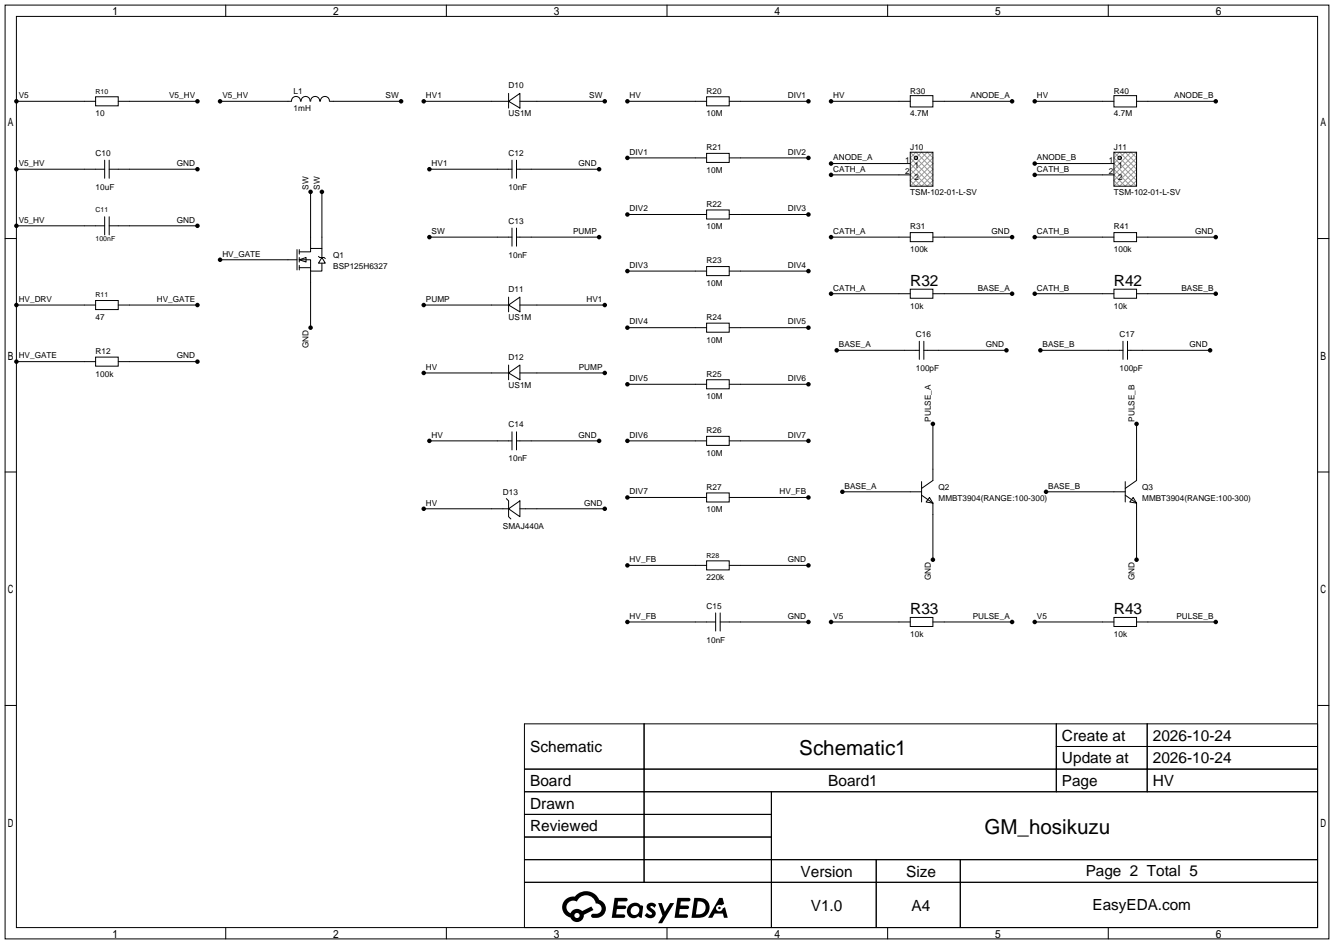
[picture p41: page 2]

Schematic | Schematic1 | Create at | 2026-10-24

Update at | 2026-10-24

Board | Board1 | Page | HV
Drawn | | GM_hosikuzu
Reviewed

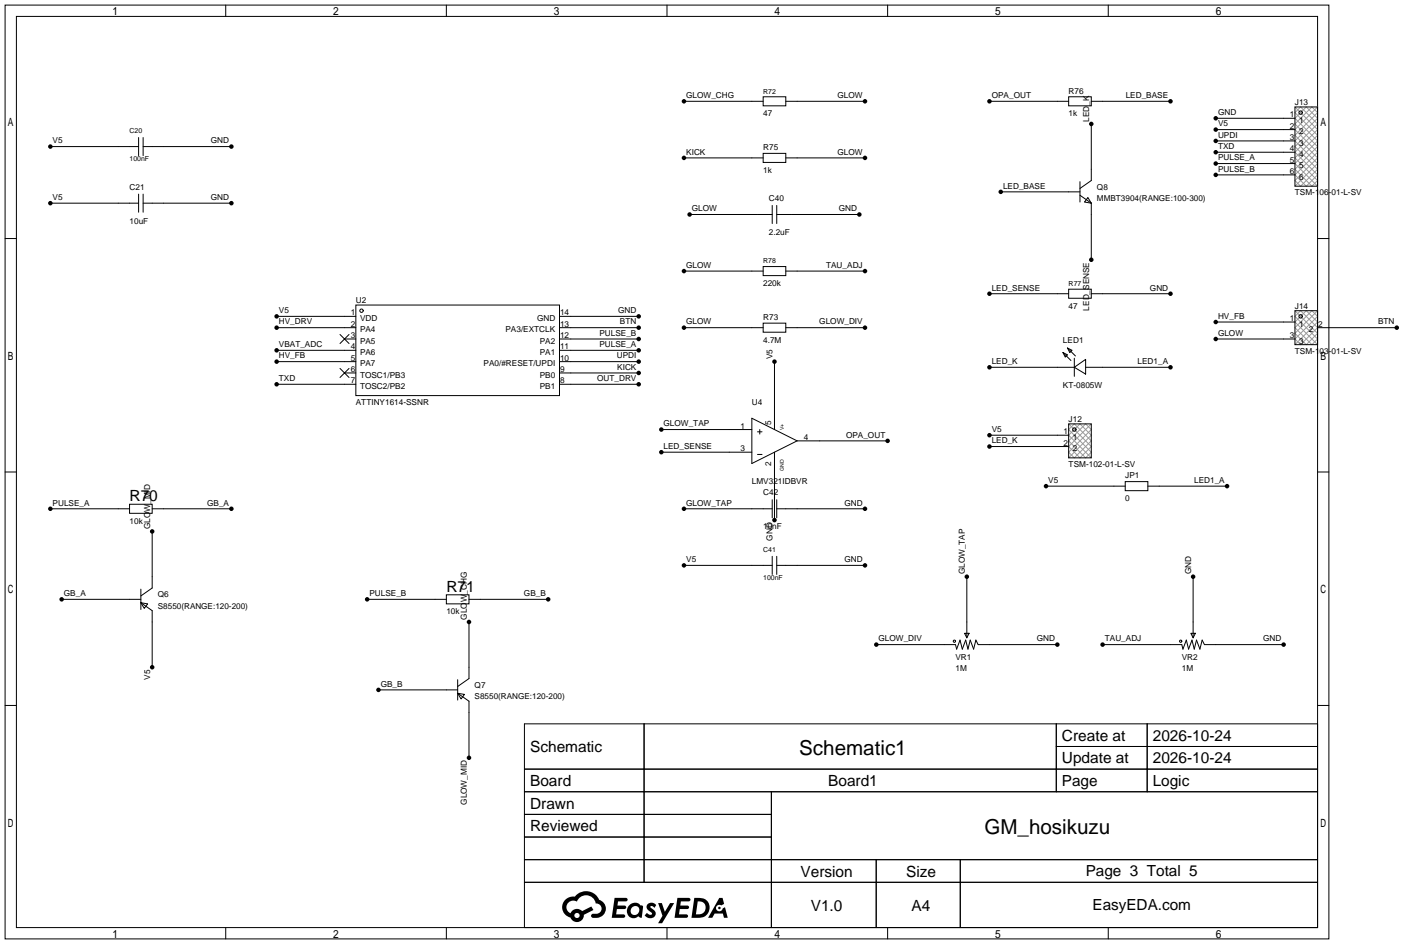
[picture p42: page 3]

PA0/#RESET/UPDI 10 PA1 11 PA2 12 PA3/EXTCLK 13 GND 14

Schematic | Schematic1 | Create at | 2026-10-24

Update at | 2026-10-24

Board | Board1 | Page | Logic
Drawn | | GM_hosikuzu
Reviewed

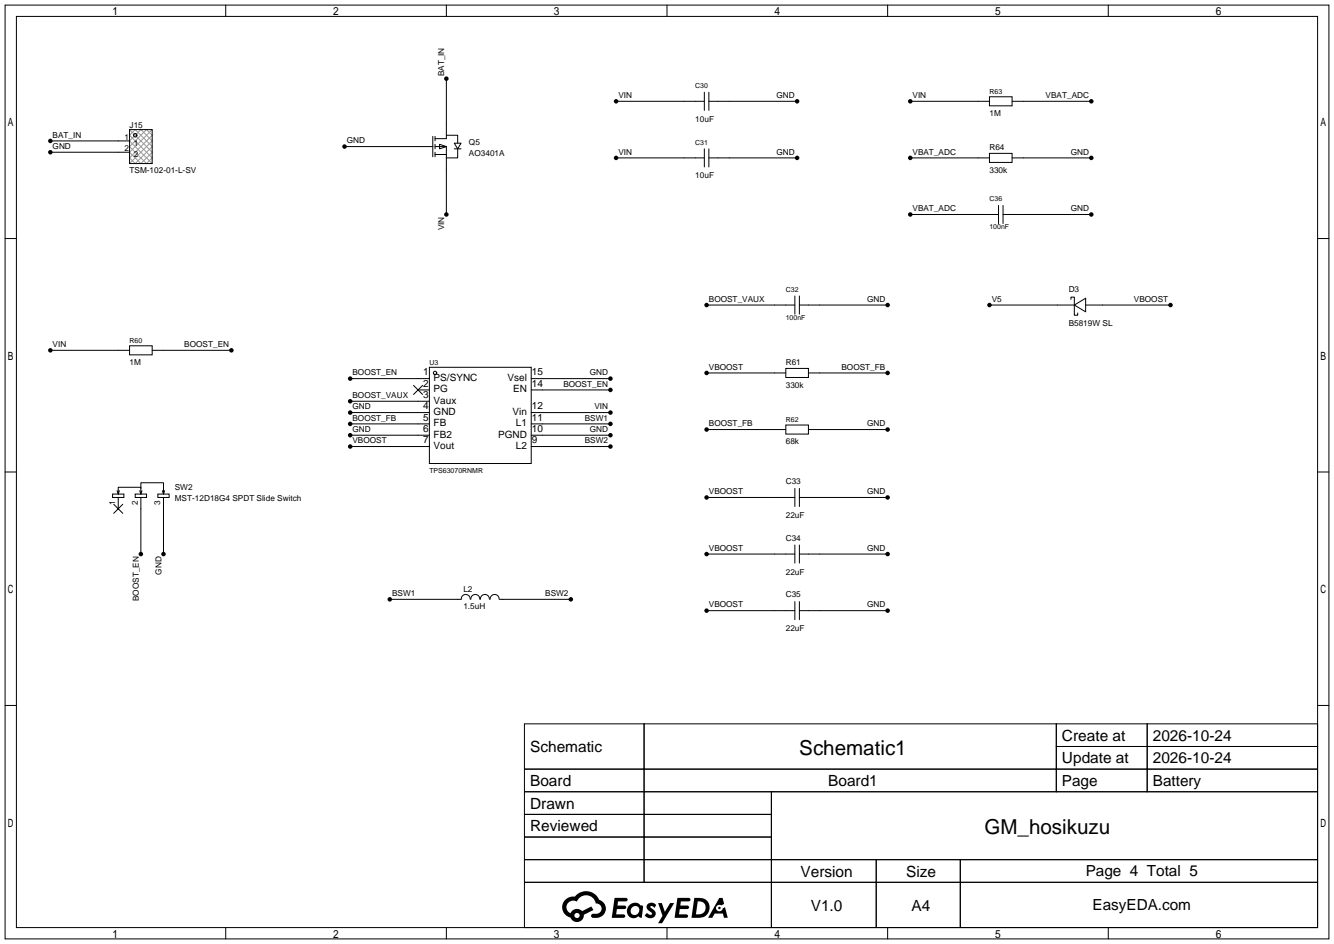
[picture p43: page 4]

MST-12D18G4 SPDT Slide Switch

Schematic | Schematic1 | Create at | 2026-10-24

Update at | 2026-10-24

Board | Board1 | Page | Battery
Drawn | | GM_hosikuzu
Reviewed

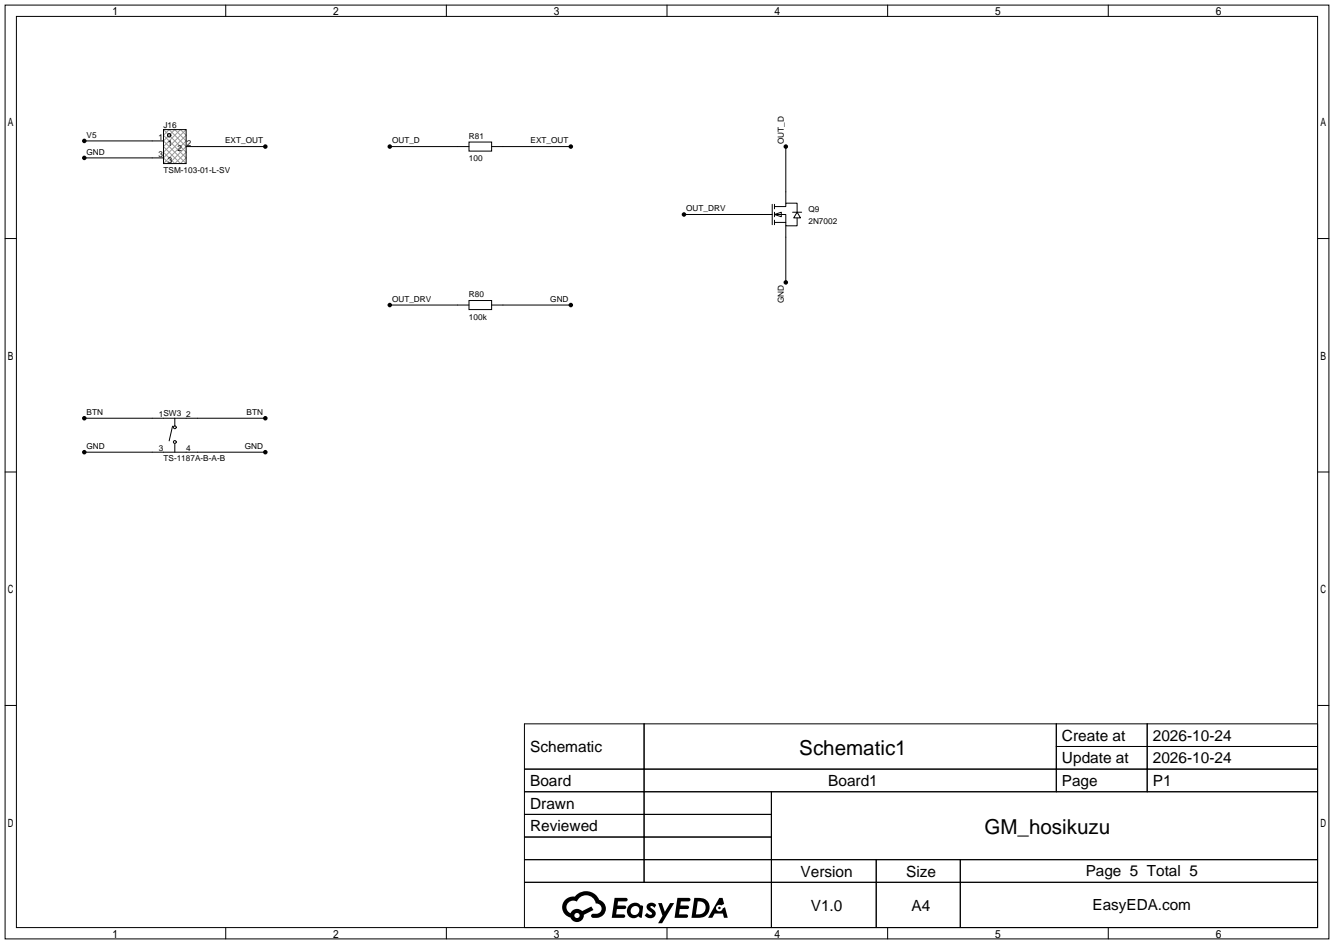
[picture p44: page 5]

Schematic | Schematic1 | Create at | 2026-10-24

Update at | 2026-10-24

Board | Board1 | Page | P1
Drawn | | GM_hosikuzu
Reviewed
