monoradio102/stardust-lamp/research/2026-11-cosmic-rays/paper/figures/en/detector.pdf

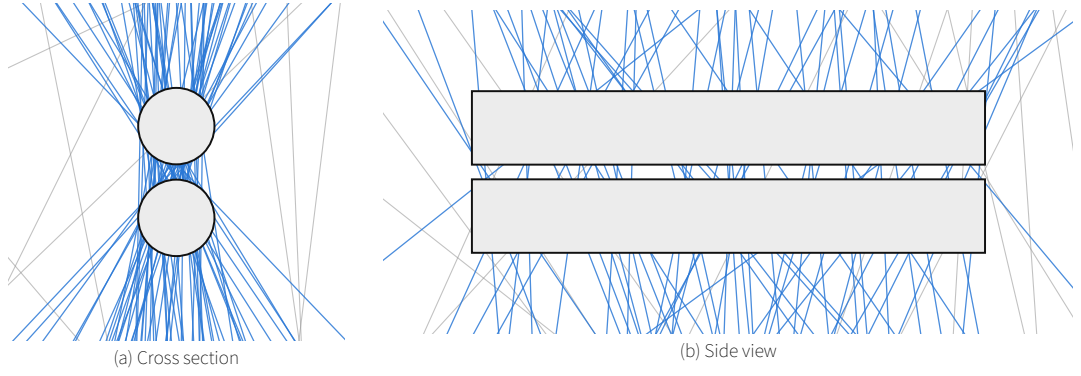
[picture p45: page 1]
(a) Cross section; (b) Side view
