monoradio102/stardust-lamp/research/2026-11-cosmic-rays/paper/figures/en/poisson.pdf

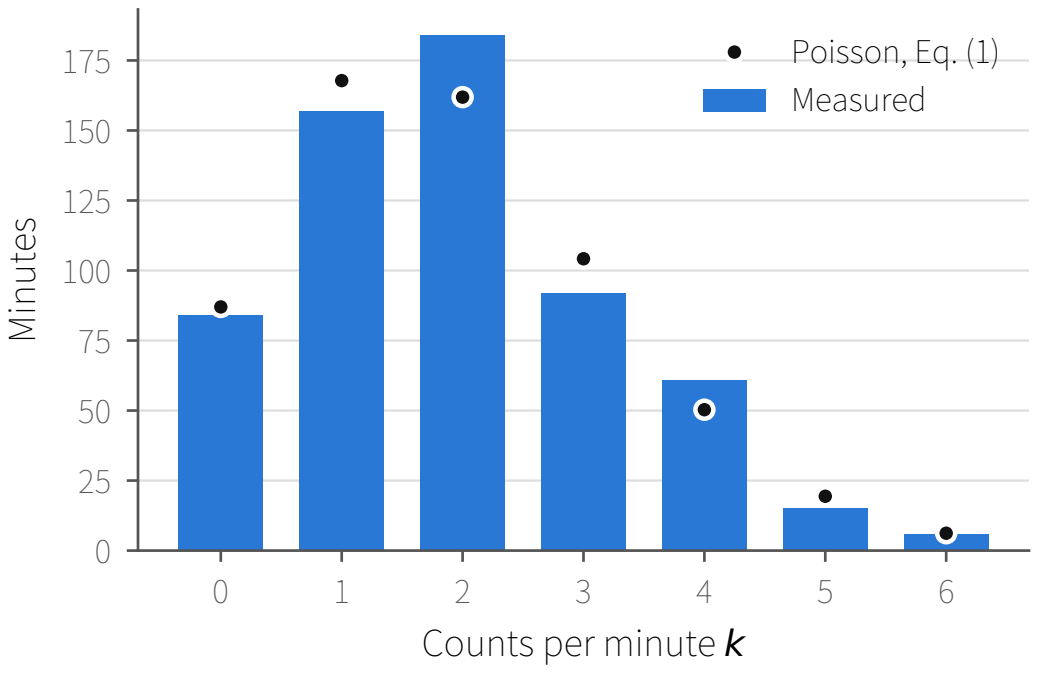
[picture p46: page 1]
min; Minutes; Poisson, Eq. (1) Measured
