monoradio102/stardust-lamp/research/2026-11-cosmic-rays/paper/figures/en/tilt.pdf

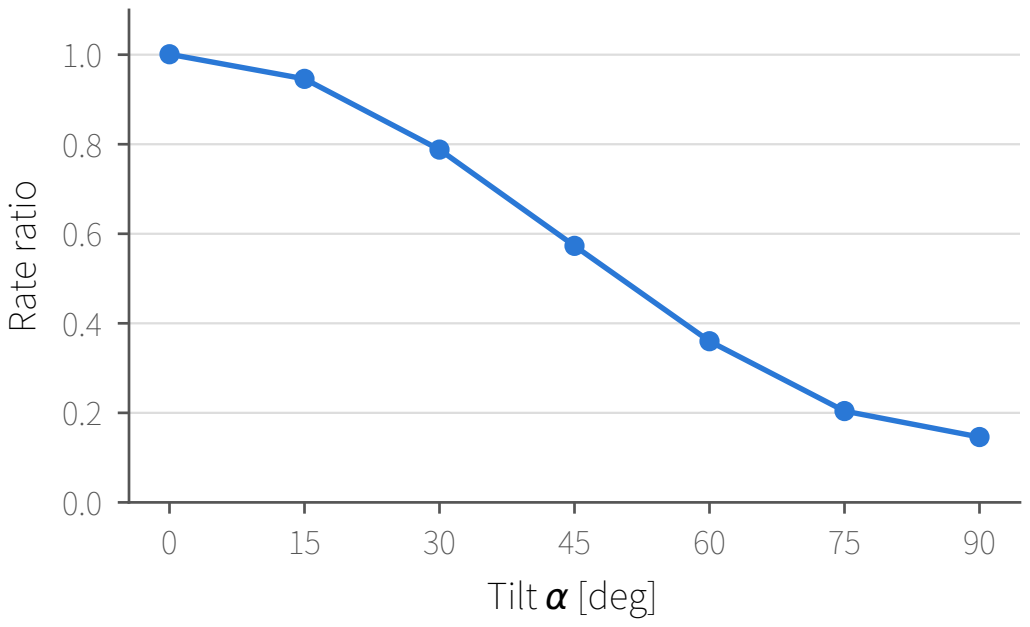
[picture p47: page 1]
90 Tilt α [deg]; Rate ratio
