monoradio102/stardust-lamp/research/2026-11-cosmic-rays/paper/figures/ja/detector.pdf

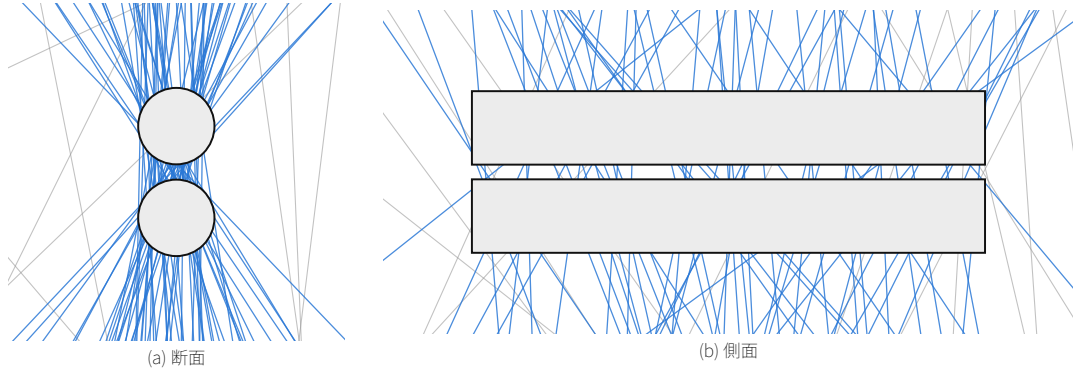
[picture p48: page 1]
