monoradio102/stardust-lamp/research/2026-11-cosmic-rays/paper/figures/ja/hourly.pdf

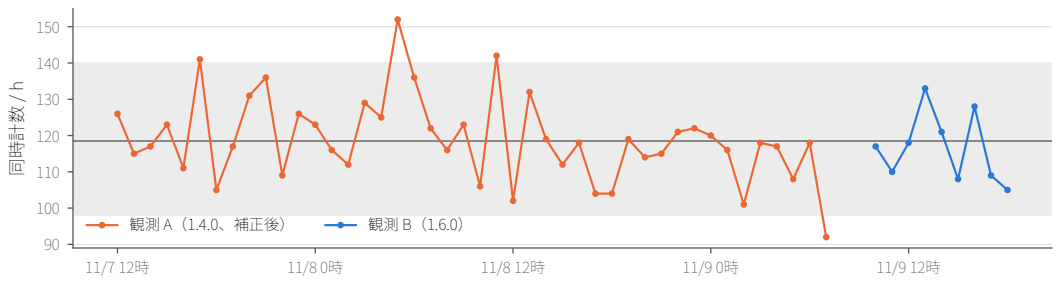
[picture p49: page 1]
同時計数 / h; 観測 A（1.4.0、補正後）
