monoradio102/stardust-lamp/research/2026-11-cosmic-rays/paper/figures/ja/poisson.pdf

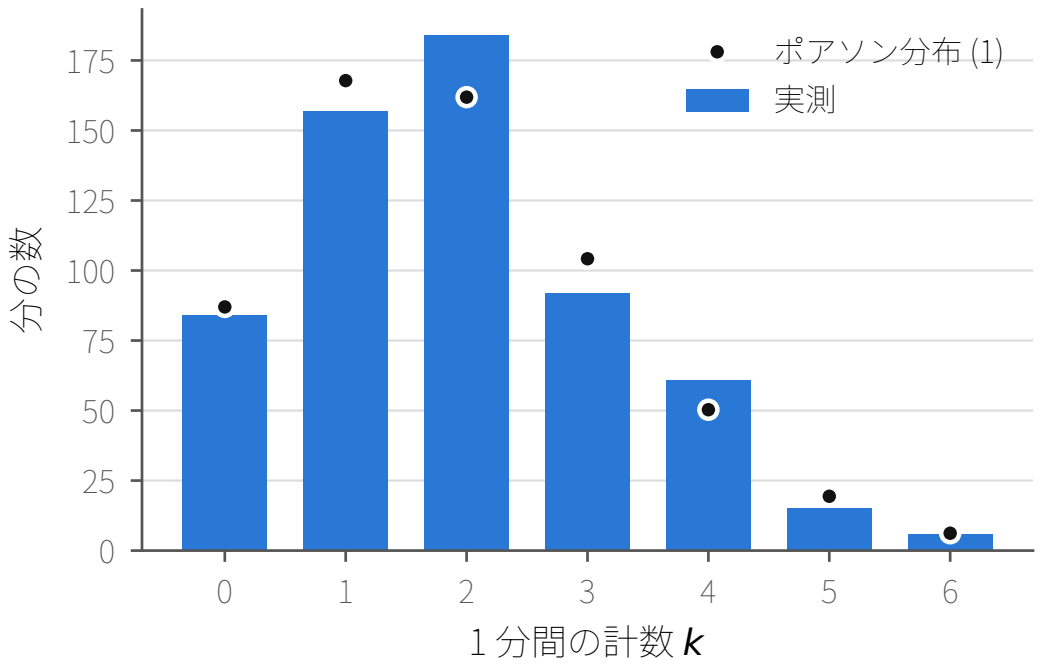
[picture p50: page 1]
分の数; ポアソン分布 (1) 実測
