monoradio102/stardust-lamp/research/2026-11-cosmic-rays/paper/figures/ja/tilt.pdf

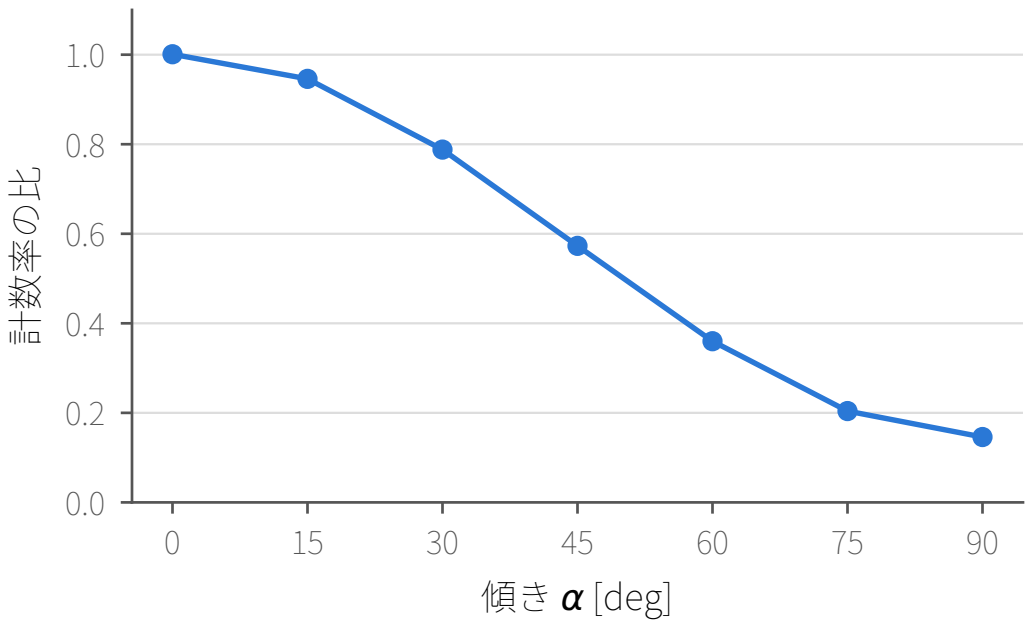
[picture p51: page 1]
90 傾き α [deg]; 計数率の比
