monoradio102/stardust-lamp/(commit log)

2026-11-06 星屑灯の Web シリアル モニターを公開
2026-11-06 つないでいないときは「未接続」と出す
2026-11-06 モニターを作り直し、ファームと回路・基板の資料を追加
    - Web モニター: 管が反応した瞬間に光る表示、数字のパネル、グラフ（10 分〜7 日）、10 秒ごとの記録データとイベント、設定・実験のタブ、白黒反転
    - firmware/stardust: ファーム 1.4.0 と変更履歴
    - hardware: 回路図・基板の図・しくみと測った結果
    - README を書き直し
2026-11-06 ロゴを追加し、モニターのヘッダーとファビコン、README に入れる
    - brand/: ロゴの SVG（縦組み・横組み・マーク・文字、3 色。文字はアウトライン化）とアイコン
    - モニター: ヘッダーにマーク、ファビコンとホーム画面用アイコン
    - README: 先頭をロゴに（ダークモードではクリーム色の版）
2026-11-06 README: 黒い基板の表と裏を横に並べた画像に
2026-11-07 README: 星屑灯のコピーを入れる
2026-11-07 README: 見出しと装置の写真、説明文のレイアウト
2026-11-07 README: 見出しを「銀河を旅する粒子で、灯す明かり」に
2026-11-07 README: 見出しを「銀河を旅する粒子が、灯す明かり」に
2026-11-07 README: 見出しを「銀河を旅する星屑が、灯す明かり」に
2026-11-09 ファーム 1.6.0: 管ごとの不感時間と、均等なパルスの高圧駆動
    - 1.5.0: 同じ管のパルスが 200 µs 以内に続いたら数えない（dead コマンドで変更可）。再パルスによる二重計数をなくす
    - 1.6.0: 高圧のパルスを 1 ms ごとにまとめず均等な間隔で打つ。LED のちらつきがなくなり、高圧の揺れも減った
    - モニター画面に不感時間の欄を追加、hardware の README を更新
2026-11-09 研究論文「星屑灯による宇宙線ミューオンの計測」を追加
    - research/2026-11-cosmic-rays: 論文調の README と日英の PDF（TeX ソースつき）
    - analyze.py と paper_figures.py で results.json・図・集計データを再生成できる
    - README から観測の記録へリンク
    [coincidences_before.csv, coincidences_main.csv, hourly_before.csv, hourly_main.csv]
2026-11-09 研究論文の README: 式番号を \tag なしで書く（GitHub で式が崩れるため）
2026-11-09 README: サムネを冒頭に、明るい部屋と光った瞬間の写真を追加
    - 冒頭の画像を、YouTube のサムネ（宇宙線が通ると、光る。）に
    - 明るい部屋の写真と、暗い部屋で光った瞬間を並べる
    - しくみに、偶然の一致 0.04%（99.9% 以上が宇宙線）と、アナログのまま光に変えることを追記
2026-11-09 README: 紹介動画（YouTube）へのリンクを追加
